marqs85/ossc_pcb/doc/bom_full.xls

Type | Id | Designator | Package | Quantity | Designation | MPN | Alternative part | Supplier URL
ICs
 | 1 | U8 | TSSOP-30_4.4x7.8mm_Pitch0.5mm_Handsoldering | 1 | PCM1862 | PCM1862DBTR |  | http://www.mouser.fi/ProductDetail/Texas-Instruments/PCM1862DBTR/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
 | 2 | U3 | TQFP-100_custom | 1 | IT6613 | IT6613E |  | Found on Aliexpress etc.
 | 3 | U10 | SOIC-8_3.9x4.9mm_Pitch1.27mm_Handsoldering | 1 | S25FL216K | IS25LP016D-JBLE |  | https://www.mouser.fi/ProductDetail/870-IS25LP016DJBLETR
 | 4 | U2 | TQFP-144_thermal | 1 | EP4CE15E22 | EP4CE15E22C8N |  | https://www.mouser.fi/ProductDetail/Intel-Altera/EP4CE15E22C8N
 | 5 | U1 | TQFP-100_thermal | 1 | TVP7002PZP | TVP7002PZP |  | https://www.mouser.fi/ProductDetail/Texas-Instruments/TVP7002PZP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
 | 6 | U4 | SOT-23-6_Handsoldering | 1 | SN74LVC2G17 | SN74LVC2G17DBVR |  | https://www.mouser.fi/Search/ProductDetail.aspx
 | 7 | U17 | TSSOP-20_4.4x6.5mm_Pitch0.65mm_Handsoldering | 1 | THS7353 | THS7353PWR |  | https://www.mouser.fi/Search/ProductDetail.aspx
Regulators
 | 8 | U7 | SOT-23-5_Handsoldering | 1 | NCP703SN19T1G | NCP703SN19T1G |  | http://www.mouser.fi/ProductDetail/ON-Semiconductor/NCP703SN19T1G/
 | 9 | U9 | SOT-23-5_Handsoldering | 1 | TLV70019 | TLV70019DDCT |  | https://www.mouser.fi/Search/ProductDetail.aspx
 | 10 | U15,U16 | SOT-23-5_Handsoldering | 2 | TLV70018 | TLV70018DDCT |  | https://www.mouser.fi/Search/ProductDetail.aspx
 | 11 | U6 | SOT-23-5_Handsoldering | 1 | TLV70033 | TLV70033DDCR |  | https://www.mouser.fi/Search/ProductDetail.aspx
 | 12 | U12,U14 | SOT-23-5_Handsoldering | 2 | TLV70012 | TLV70012DDCT |  | https://www.mouser.fi/Search/ProductDetail.aspx
 | 13 | U13 | SOT-23-5_Handsoldering | 1 | TLV70025 | TLV70025DDCT |  | https://www.mouser.fi/Search/ProductDetail.aspx
 | 14 | U5 | SOT-223_Handsoldering | 1 | AP7361C | AP7361C-33E-13 |  | http://www.mouser.fi/ProductDetail/Diodes-Incorporated/AP7361C-33E-13/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
 | 15 | U18 | SOT-23-5_Handsoldering | 1 | LM3671MF-2.5/NOPB | LM3671MF-2.5/NOPB |  | https://www.mouser.fi/ProductDetail/Texas-Instruments/LM3671MF-25-NOPB/?qs=QbsRYf82W3EGm7MxEdl1Ew%3D%3D
Connectors
 | 16 | P1 | VASCH5x2 | 1 | JTAG_CONN | 30310-6002HB |  | https://www.mouser.fi/Search/ProductDetail.aspx
 | 17 | P3 | DM3D-SF | 1 | mSD_CONN | DM3D-SF |  | https://www.mouser.fi/Search/ProductDetail.aspx?R=DM3D-SFvirtualkey64550000virtualkey798-DM3D-SF
 | 18 | J1 | VGA_CONN | 1 | VGA | ICD15S13E4GX00LF |  | https://www.mouser.fi/Search/ProductDetail.aspx
 | 19 | J3 | SCART_CONN | 1 | SCART-F | K-SCARTX-022 | CS-107 | Found on Aliexpress etc.
 | 20 | J2 | 3xRCA_CONN | 1 | 3XRCA_CONN | PJRAN3X1U03X |  | http://www.mouser.fi/ProductDetail/Switchcraft/PJRAN3X1U03X/
 | 21 | J5 | BARREL_JACK_roundconn | 1 | 5VDC_IN | 163-179PH-EX |  | https://www.mouser.fi/Search/ProductDetail.aspx
 | 22 | J6,J7 | SJ1-3533NG | 2 | SJ1-3533NG | SJ1-3533NG |  | http://www.mouser.fi/ProductDetail/CUI-Inc/SJ1-3533NG/
 | 23 | J4 | HDMI_CONN-10029449-111RLF | 1 | HDMI_CONN | 10029449-111RLF |  | http://www.mouser.fi/Search/ProductDetail.aspx
Switches / buttons
 | 24 | SW3,SW2 | SW_PUSH-SKHCBFA010 | 2 | SW_PUSH | SKHCBFA010 |  | https://www.mouser.fi/Search/ProductDetail.aspx
 | 25 | SW1 | SW_SPDT | 1 | SPST | 100SP1T1B1M2QEH |  | http://www.mouser.fi/Search/ProductDetail.aspx
 | 26 | SW4 | GW22RxV | 1 | GW22RCV | GW22RBV |  | https://www.mouser.fi/ProductDetail/NKK-Switches/GW22RBV/
SMD R/L/C/D/Q
 | 27 | D1 | LED-0603 | 1 | LEDR | LTST-C194KRKT |  | https://www.mouser.fi/Search/ProductDetail.aspx
 | 28 | D2 | LED-0603 | 1 | LEDG | LTST-C194KGKT |  | https://www.mouser.fi/Search/ProductDetail.aspx
 | 29 | D4,D3 | SOT-665 | 2 | PESD3V3V4UW | PESD3V3V4UW |  | https://www.mouser.fi/ProductDetail/Nexperia/PESD3V3V4UW115/?qs=LOCUfHb8d9t0XGTkzdBMLg%3D%3D
 | 30 | D12,D11,D5 | SOT-23_Handsoldering | 3 | PESD12VL2BT | PESD12VL2BT |  | https://www.mouser.fi/ProductDetail/Nexperia/PESD12VL2BT215/?qs=LOCUfHb8d9uAuKXx9HIYFw%3D%3D
 | 31 | D10,D9,D8 | SOT-665 | 3 | PESD5V0U4BW | PESD5V0U4BW |  | https://www.mouser.fi/ProductDetail/Nexperia/PESD5V0U4BW115/?qs=PJ263BbL1t0YkETjSt5Low%3D%3D
 | 32 | D15,D13 | SOT-665 | 2 | PESD5V0V4UW | PESD5V0V4UW |  | https://www.mouser.fi/ProductDetail/Nexperia/PESD5V0V4UW115/?qs=LOCUfHb8d9ugScE2ypB%2FRQ%3D%3D
 | 33 | D7,D6 | SLP2510P8 | 2 | RClamp0524P | RCLAMP0524PATCT |  | http://www.mouser.fi/ProductDetail/Semtech/RCLAMP0524PATCT/
 | 34 | D14 | SOT-23_Handsoldering | 1 | BZX84C5V1/SOT | BZX84-C5V1 |  | https://www.mouser.fi/ProductDetail/Nexperia/BZX84-C5V1215/?qs=me8TqzrmIYVKCqOFbOtofg%3D%3D
 | 35 | L1 | CDRH2D14 | 1 | 2.2u | CDRH2D14NP-2R2NC |  | https://www.mouser.fi/ProductDetail/Sumida/CDRH2D14NP-2R2NC/?qs=yEEOfDmvQDXT35Jdz6aZxg%3D%3D
 | 36 | Q1 | SOT-23_Handsoldering | 1 | BC847 | BC847C,215 |  | https://www.mouser.fi/Search/ProductDetail.aspx
 | 37 | Q2 | SOT-23_Handsoldering | 1 | BC857 | BC857C,215 |  | https://www.mouser.fi/Search/ProductDetail.aspx
 | 38 | Q5,Q3 | SOT-23_Handsoldering | 2 | AOSS21115C | AOSS21115C |  | https://www.digikey.fi/product-detail/en/alpha-omega-semiconductor-inc/AOSS21115C/785-AOSS21115CCT-ND/12327570
 | 39 | Q4 | SOT-23_Handsoldering | 1 | DSS20200L | DSS20200L |  | https://www.mouser.fi/ProductDetail/Diodes-Incorporated/DSS20200L-7/?qs=oUsD4qhOtFyoU8lfgTjONg%3D%3D
 | 40 | FB6,FB1,FB2,FB4,FB5,FB7 | SM0603_Resistor_libcms | 6 | MPZ1608S221A | MPZ1608S221A |  | https://www.mouser.fi/Search/ProductDetail.aspx
 | 41 | R23 | SM0603_Resistor_libcms | 1 | 25 | RR0816Q-24R9-D-39R | RC0603FR-0724R9L | https://www.mouser.fi/Search/ProductDetail.aspx
 | 42 | R34,R27 | SM0603_Resistor_libcms | 2 | 47 | RR0816Q-470-D | RC0603FR-0747RL | https://www.mouser.fi/ProductDetail/Susumu/RR0816Q-470-D/
 | 43 | R1,R2,R4,R5,R6,R7,R8,R9,R10,R3 | SM0603_Resistor_libcms | 10 | 75 | RG1608P-750-D-T5 | RT0603DRE0775RL | https://www.mouser.fi/Search/ProductDetail.aspx
 | 44 | R64,R63,R62,R61,R60,R59,R38,R44 | SM0603_Resistor_libcms | 8 | 100 | RR0816P-101-D | RC0603FR-07100RL | https://www.mouser.fi/ProductDetail/Susumu/RR0816P-101-D/
 | 45 | R12 | SM0603_Resistor_libcms | 1 | 220 | RR0816P-221-D | RC0603FR-07220RL | http://www.mouser.fi/ProductDetail/Susumu/RR0816P-221-D/
 | 46 | R35,R36 | SM0603_Resistor_libcms | 2 | 330 | RR0816P-331-D | RC0603FR-07330RL | https://www.mouser.fi/Search/ProductDetail.aspx
 | 47 | R55 | SM0805_libcms | 1 | 330 | CRCW0805330RFKEAHP |  | https://www.mouser.fi/ProductDetail/Vishay-Dale/CRCW0805330RFKEAHP/
 | 48 | R25 | SM0603_Resistor_libcms | 1 | 698 | RR0816P-6980-D-82A | RT0603DRE07698RL | https://www.mouser.fi/Search/ProductDetail.aspx
 | 49 | R20,R26,R37,R40 | SM0603_Resistor_libcms | 4 | 1k | RR0816P-102-D | RC0603FR-071KL | https://www.mouser.fi/Search/ProductDetail.aspx
 | 50 | R11 | SM0603_Resistor_libcms | 1 | 1.5k | RR0816P-152-D | RC0603FR-071K5L | https://www.mouser.fi/ProductDetail/Susumu/RR0816P-152-D/
 | 51 | R13,R14,R15 | SM0603_Resistor_libcms | 3 | 2.2k | RR0816P-222-D | RC0603FR-072K2L | https://www.mouser.fi/ProductDetail/Susumu/RR0816P-222-D/
 | 52 | R19,R24,R41,R45,R46 | SM0603_Resistor_libcms | 5 | 4.7k | RR0816P-472-D | RC0603FR-074K7L | https://www.mouser.fi/ProductDetail/Susumu/RR0816P-472-D/
 | 53 | R58,R56 | SM0603_Resistor_libcms | 2 | 6.8k | RR0816P-682-D | RC0603FR-076K8L | https://www.mouser.fi/ProductDetail/Susumu/RR0816P-682-D/
 | 54 | R16,R17,R18,R21,R22,R28,R29,R30,R31,R32,R33,R42,R43,R39 | SM0603_Resistor_libcms | 14 | 10k | RR0816P-103-D | RC0603FR-0710KL | https://www.mouser.fi/Search/ProductDetail.aspx
 | 55 | R54,R53 | SM0603_Resistor_libcms | 2 | 27k | RR0816P-273-D | RC0603FR-0727KL | https://www.mouser.fi/ProductDetail/Susumu/RR0816P-273-D/
 | 56 | R57,R47,R48,R49,R50,R51,R52 | SM0603_Resistor_libcms | 6 | 100k | RR0816P-104-D | RC0603FR-07100KL | http://www.mouser.fi/ProductDetail/Susumu/RR0816P-104-D/
 | 57 | C33,C36 | SM0603_Capa_libcms | 2 | 22p | GRM1885C1H220JA01D | CC0603JRNPO9BN220 | http://www.mouser.fi/ProductDetail/Murata-Electronics/GRM1885C1H220JA01D/
 | 58 | C111,C112 | SM0603_Capa_libcms | 2 | 30p | GRM1885C1H300FA01D | CC0603JRNPO9BN300 | http://www.mouser.fi/ProductDetail/Murata-Electronics/GRM1885C1H300FA01D/
 | 59 | C11,C13,C16,C24 | SM0603_Capa_libcms | 4 | 1n | VJ0603Y102KXACW1BC | CC0603KRX7R9BB102 | https://www.mouser.fi/Search/ProductDetail.aspx
 | 60 | C19 | SM0603_Capa_libcms | 1 | 4.7n | VJ0603Y472KXBPW1BC | C1608X7R1H472KT000N | https://www.mouser.fi/Search/ProductDetail.aspx
 | 61 | C132,C131,C130,C129,C128,C127,C17,C25,C70,C104,C105,C106 | SM0603_Capa_libcms | 12 | 10n | VJ0603Y103KXACW1BC | CC0603KRX7R9BB103 | https://www.mouser.fi/Search/ProductDetail.aspx
 | 62 | C1,C2,C8,C9,C10,C14,C15,C18,C20,C21,C22,C23,C26,C27,C28,C39,C40,C41,C42,C43,C44,C45,C46,C47,C48,C50,C51,C53,C54,C55,C57,C58,C59,C60,C61,C62,C63,C64,C65,C66,C67,C68,C69,C73,C74,C75,C77,C78,C79,C80,C81,C82,C83,C84,C85,C86,C99,C101,C72,C76,C100,C103,C114,C118 | SM0603_Capa_libcms | 64 | 0.1u | VJ0603Y104JXJPW1BC | CC0603KRX7R9BB104 | https://www.mouser.fi/Search/ProductDetail.aspx
 | 63 | C3,C4,C5,C6,C7,C12,C29,C30,C32,C34,C35,C37,C38,C52,C56,C87,C88,C89,C90,C91,C92,C94,C95,C96,C97,C98 | SM0603_Capa_libcms | 26 | 1u | GRT188R61H105KE13D | CC0603KRX7R8BB105 | https://www.mouser.fi/ProductDetail/Murata-Electronics/GRT188R61H105KE13D
 | 64 | C119,C120 | SM0603_Capa_libcms | 2 | 2.2u | GCM188R70J225KE22D | GRM188Z71E225KE43D | http://www.mouser.fi/ProductDetail/Murata-Electronics/GCM188R70J225KE22D/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
 | 65 | C116,C121,C122,C117,C31,C93,C49,C108,C109,C110,C113,C115,C123,C124,C125,C126 | SM0603_Capa_libcms | 16 | 10u | ZRB18AR61E106ME01L | GRM188Z71A106KA73D | https://www.mouser.fi/ProductDetail/Murata-Electronics/ZRB18AR61E106ME01L
 | 66 | C102,C71,C107 | SM0805_libcms | 3 | 47u | GRM21BR60J476ME15L | CL21A476MQYNNNG | http://www.mouser.fi/Search/ProductDetail.aspx
Misc
 | 67 | F1 | SM0603_Resistor_libcms | 1 | F0603E1R25FSTR | F0603E1R25FSTR |  | https://www.mouser.fi/ProductDetail/AVX/F0603E1R25FSTR/
 | 68 | F2 | SM0603_Resistor_libcms | 1 | MF-FSMF020X-2 | MF-FSMF020X-2 |  | https://www.mouser.fi/Search/ProductDetail.aspx
 | 69 | Y1 | ACHL-OSC | 1 | ACHL-27MHZ-EK | ACHL-27.000MHZ-EK |  | https://www.mouser.fi/Search/ProductDetail.aspx
 | 70 | Y2 | ECS-3X9X | 1 | 24.576MHz | ECS-245.7-18-9X |  | http://www.mouser.fi/Search/ProductDetail.aspx
 | 71 | U11 | IRM-V5XX_TR1 | 1 | IRM-V538/TR1 | IRM-V538/TR1 |  | Found on Aliexpress etc.
 | 72 | DS1 | NHD-C0216CZ_vertmount | 1 | CONN_01X12 | NHD-C0216CZ-FSW-FBW-3V3 |  | https://www.mouser.fi/Search/ProductDetail.aspx
Case mechanical
 | 73 | 12mm nylon spacer between PCB and mid plexi |  | 4 |  | R30-1611200 |  | https://www.mouser.fi/Search/ProductDetail.aspx
 | 74 | 8mm nylon spacer between top and mid plexi |  | 4 |  | R30-1610800 |  | https://www.mouser.fi/Search/ProductDetail.aspx
 | 75 | M3 nut between bottom plexi and PCB |  | 4
 | 76 | M3 x 16mm screw, DIN-7985 |  | 4
 | 77 | M3 x 10mm screw, DIN-7985 |  | 4
 | 78 | Bumper pad |  | 4 |  | SJ-5312 CLEAR |  | http://www.mouser.fi/ProductDetail/3M-Electronic-Specialty/SJ-5312-CLEAR/
 | 79 | 14mm x 14mm heatsink with adhesive tape for TVP7002 |  | 1 |  | GD024 |  | http://www.aliexpress.com/item/50pcs-lot-Aluminum-Cooling-Heat-sink-14-x-14-x-6MM-Golden-Chipset-RAM-Heatsink-Radiator/32245171440.html
 |  |  |  |  |  | (=included in VGP advanced DIY kit)
