marqs85/ossc_pcb/case/ossc_case_bottom.step

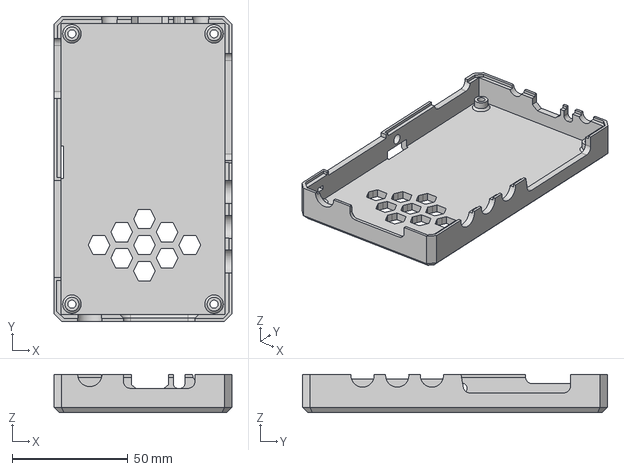
[picture p1: CAD file, 2021-12-11]
case/ossc_case_bottom.step
77.0 x 132.0 x 16.5 mm
