marqs85/ossc_pcb/case/ossc_case_top.step

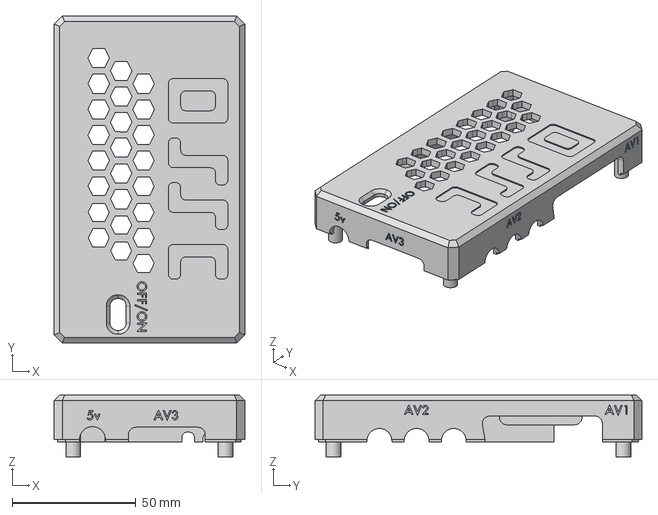
[picture p2: CAD file, 2021-12-11]
case/ossc_case_top.step
77.0 x 132.0 x 25.0 mm
