marqs85/ossc_pcb/(threads)

Thread 1 (2017-04-05):

Can we have the pcb files for V1.5 of the board?

renegadeandy, 2017-04-05:
Hi Marqs!

Can you please upload the v1.5 ossc perhaps into a v1.5 branch? I am considering ordering a couple of the boards myself and this would help me out a lot!

Also - is there a way I can contact you directly?

Many thanks

marqs85, 2017-04-23:
v1.5 and earlier pcb files are not that well maintained and contain legacy stuff that may work well with recent Kicad versions so aside from gerbers they might not be that useful. Just uploaded finished v1.6 design (untested yet though) that should be used for new boards.

My contact details can be found on top of ossc source files (Verilog/C) in the main repo.

Closed 2017-06-06.

Thread 2 (2017-06-05):

Acrylic case designs

dwhinham, 2017-06-05:
Hi marqs!

Would it be possible to please get the designs/files for the acrylic case as seen in the OSSCs sold by VideogamePerfection?

Maybe a separate repo would be more appropriate, if not here.

Thanks very much! :)

marqs85, 2017-06-06:
Case design for v1.6 PCB will be added here once it is finished

Closed 2017-06-06.

Thread 5 (2018-01-20):

Alternative for S25FL116K0XMFI041

stozze, 2018-01-20:
Hi,

First of all, thank you for making the OSSC open hardware/source, excellent work.

I've been busy soldering together an OSSC and today I finally got it completed and it worked like a charm, no magic smoke :). But I was not able to source the S25FL116K0XMFI041 (seems like these are no longer manufactured?) but I found a drop-in replacement that can be used instead, the IS25LP016D-JNLE, this one is more readily available and seems to work fine as a replacement, at least on the board I got up and running today, Quartus didn't complain about it either and programmed it just fine.

https://www.mouser.fi/ProductDetail/870-IS25LP016D-JNLE

So for the next version of the board maybe it would be better to use this one instead as it is more readily available?

marqs85, 2018-01-20:
Updated BOM with the part in 35ba794.

Closed 2018-01-20.

Thread 6 (2018-07-07):

OSSC_BOARD.WRL v1.5

Deneteus, 2018-07-07:
Howdy Marqs!

I need the OSSC_BOARD.WRL file from 1.5 or a 3D render of the 1.5 board with components. from the 1.5 Branch. Thanks in advance!

marqs85, 2018-07-09:
I can generate WRL of the PCB itself, but there are no 3d models for manually created components. Basic components also may not map automatically to 3d models due to v1.5 having been done with old Kicad version which has different library format than Kicad 5.0.

Deneteus, 2018-07-24:
That would work.

marqs85, 2018-07-30:
WRL for v1.5-DIY is now uploaded [here](https://www.niksula.hut.fi/~mhiienka/ossc/diy-v1.5/pcb1.5-diy.wrl).

Closed 2018-09-28.

Thread 8 (2019-10-24):

Y2 Unsecured

gbrown128, 2019-10-24:
Hi Marqs,
On my unit Y2 (audio ADC crystal) was installed with quite a lot of lead length between it and the board. It had flopped over and was worryingly close to touching the back of the SCART connector pins.

Depends on your manufacturing process, but I'd suggest swapping to a horizontal footprint with a solder pad to tie the crystal can to the PCB, or adding the wire loop to brace the crystal in place, or just some super glue, as I've used to fix mine!

 Otherwise very pleased with the design - thank you very much!

marqs85, 2019-10-25:
Where did you buy your board from? The crystal should lie horizontally without too much extra lead length. A different footprint could indeed be a better solution even though so far I've not heard anyone else having such issues. SMD footprint would most compact and robust, but it's not ideal when DIY aspect is considered.

gbrown128, 2019-10-28:
Board came from videogameperfection.com  Unfortunately I neglected to grab a picture before gluing it down, but that's the amount of lead length present on my unit.

It's possible my unit just had a rather rough ride in shipping, but the crystal was bent over about 45 degrees in all three axes. To be fair it is quite possible it would've never caused an issue. I just happened to take the lid off my unit out of curiosity and the crystal caught my eye! Given this unit will travel a lot I thought it best to glue it down!

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

marqs85, 2019-10-29:
The problem has been reported to manufacturer, closing the issue.

Closed 2019-10-29.
