marqs85/ossc_pcb/doc/ossc_board.pdf

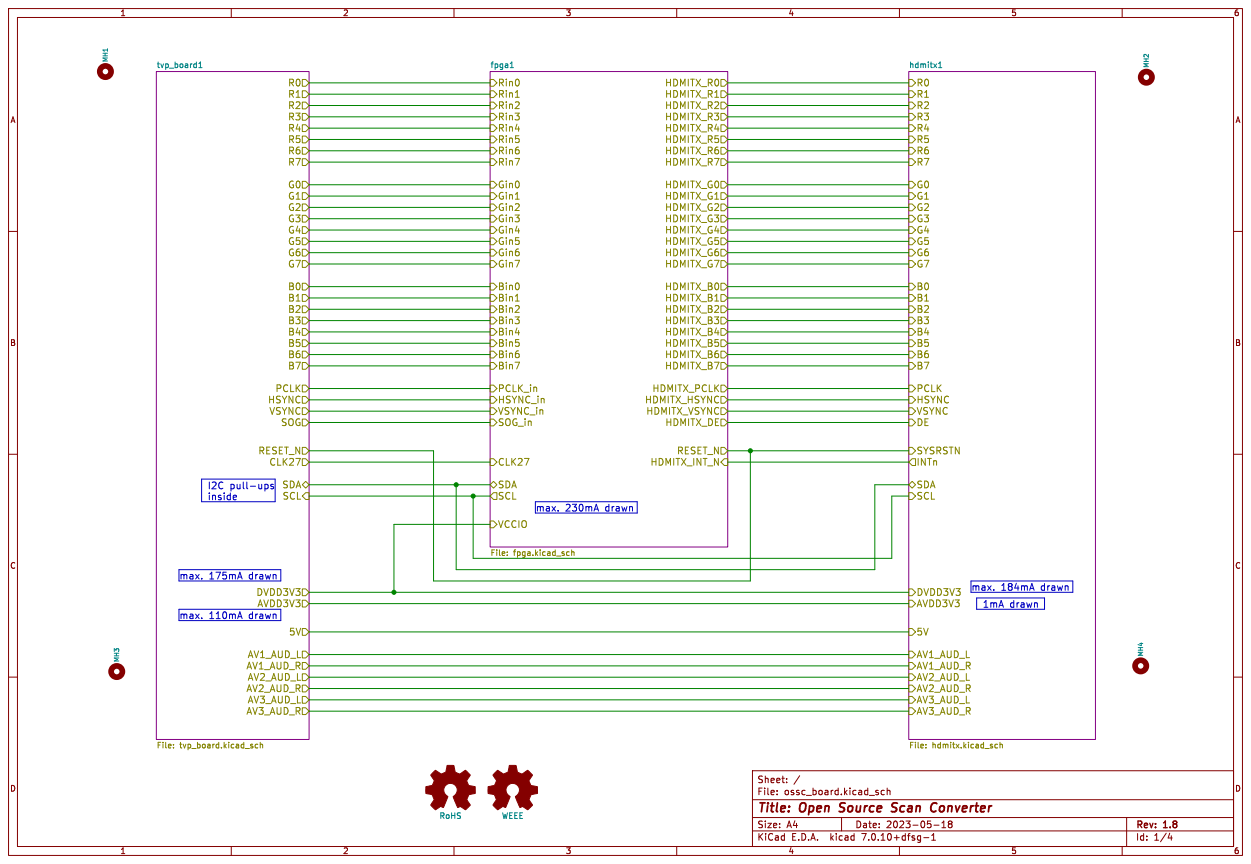
[picture p3: page 1]

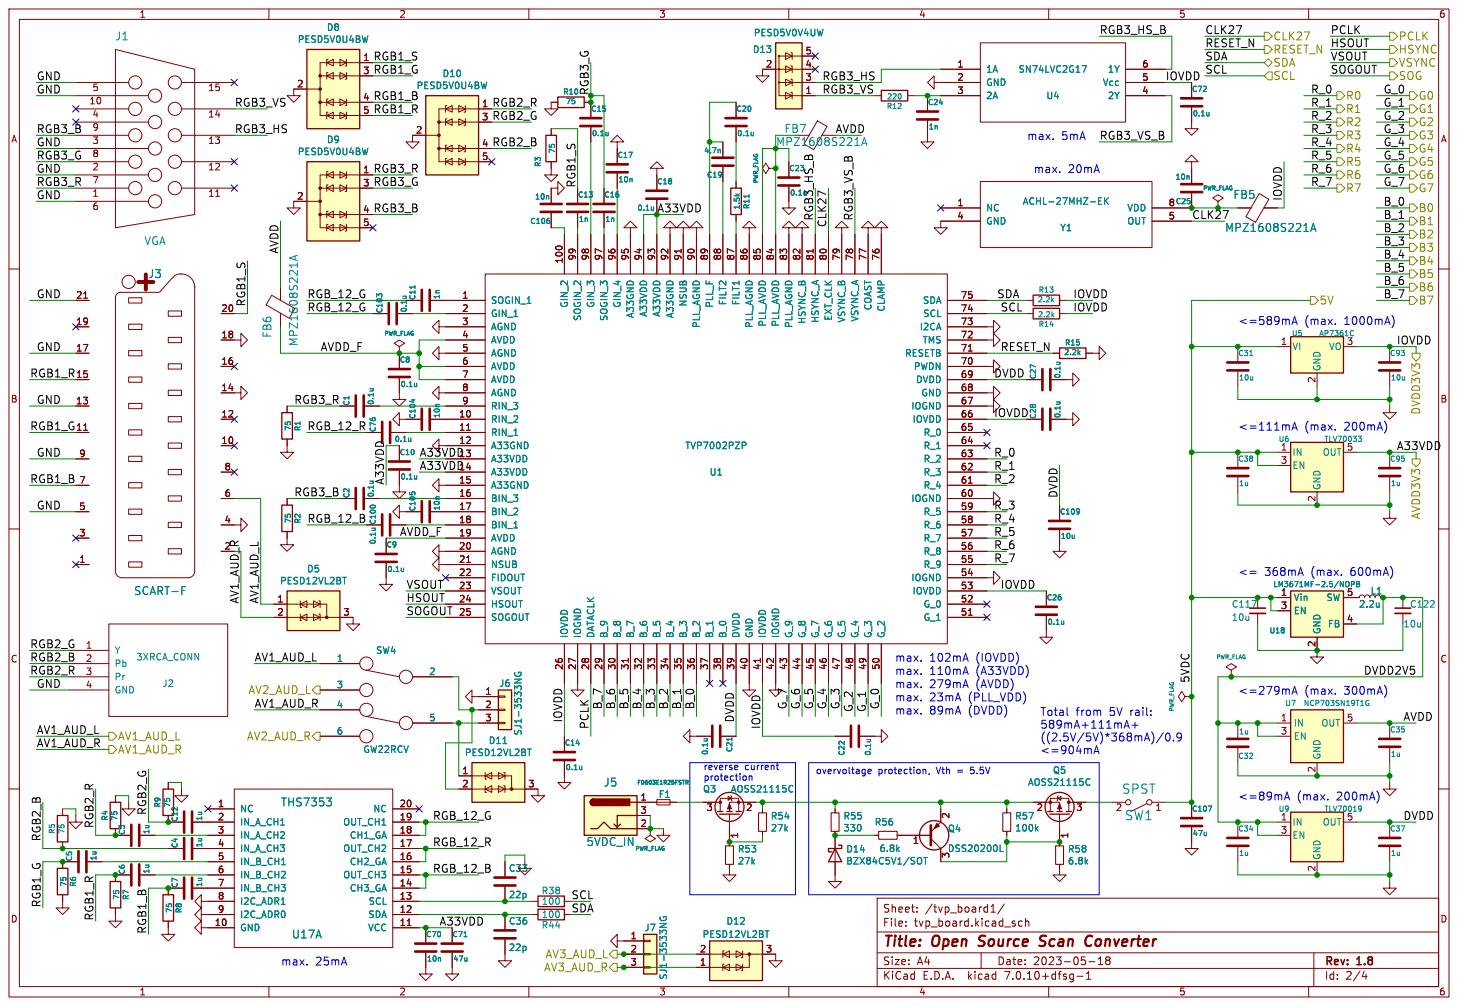
[picture p4: page 2]

Id: 2/4 Title: Open Source Scan Converter File: tvp_board.kicad_sch Sheet: /tvp_board1/ C36

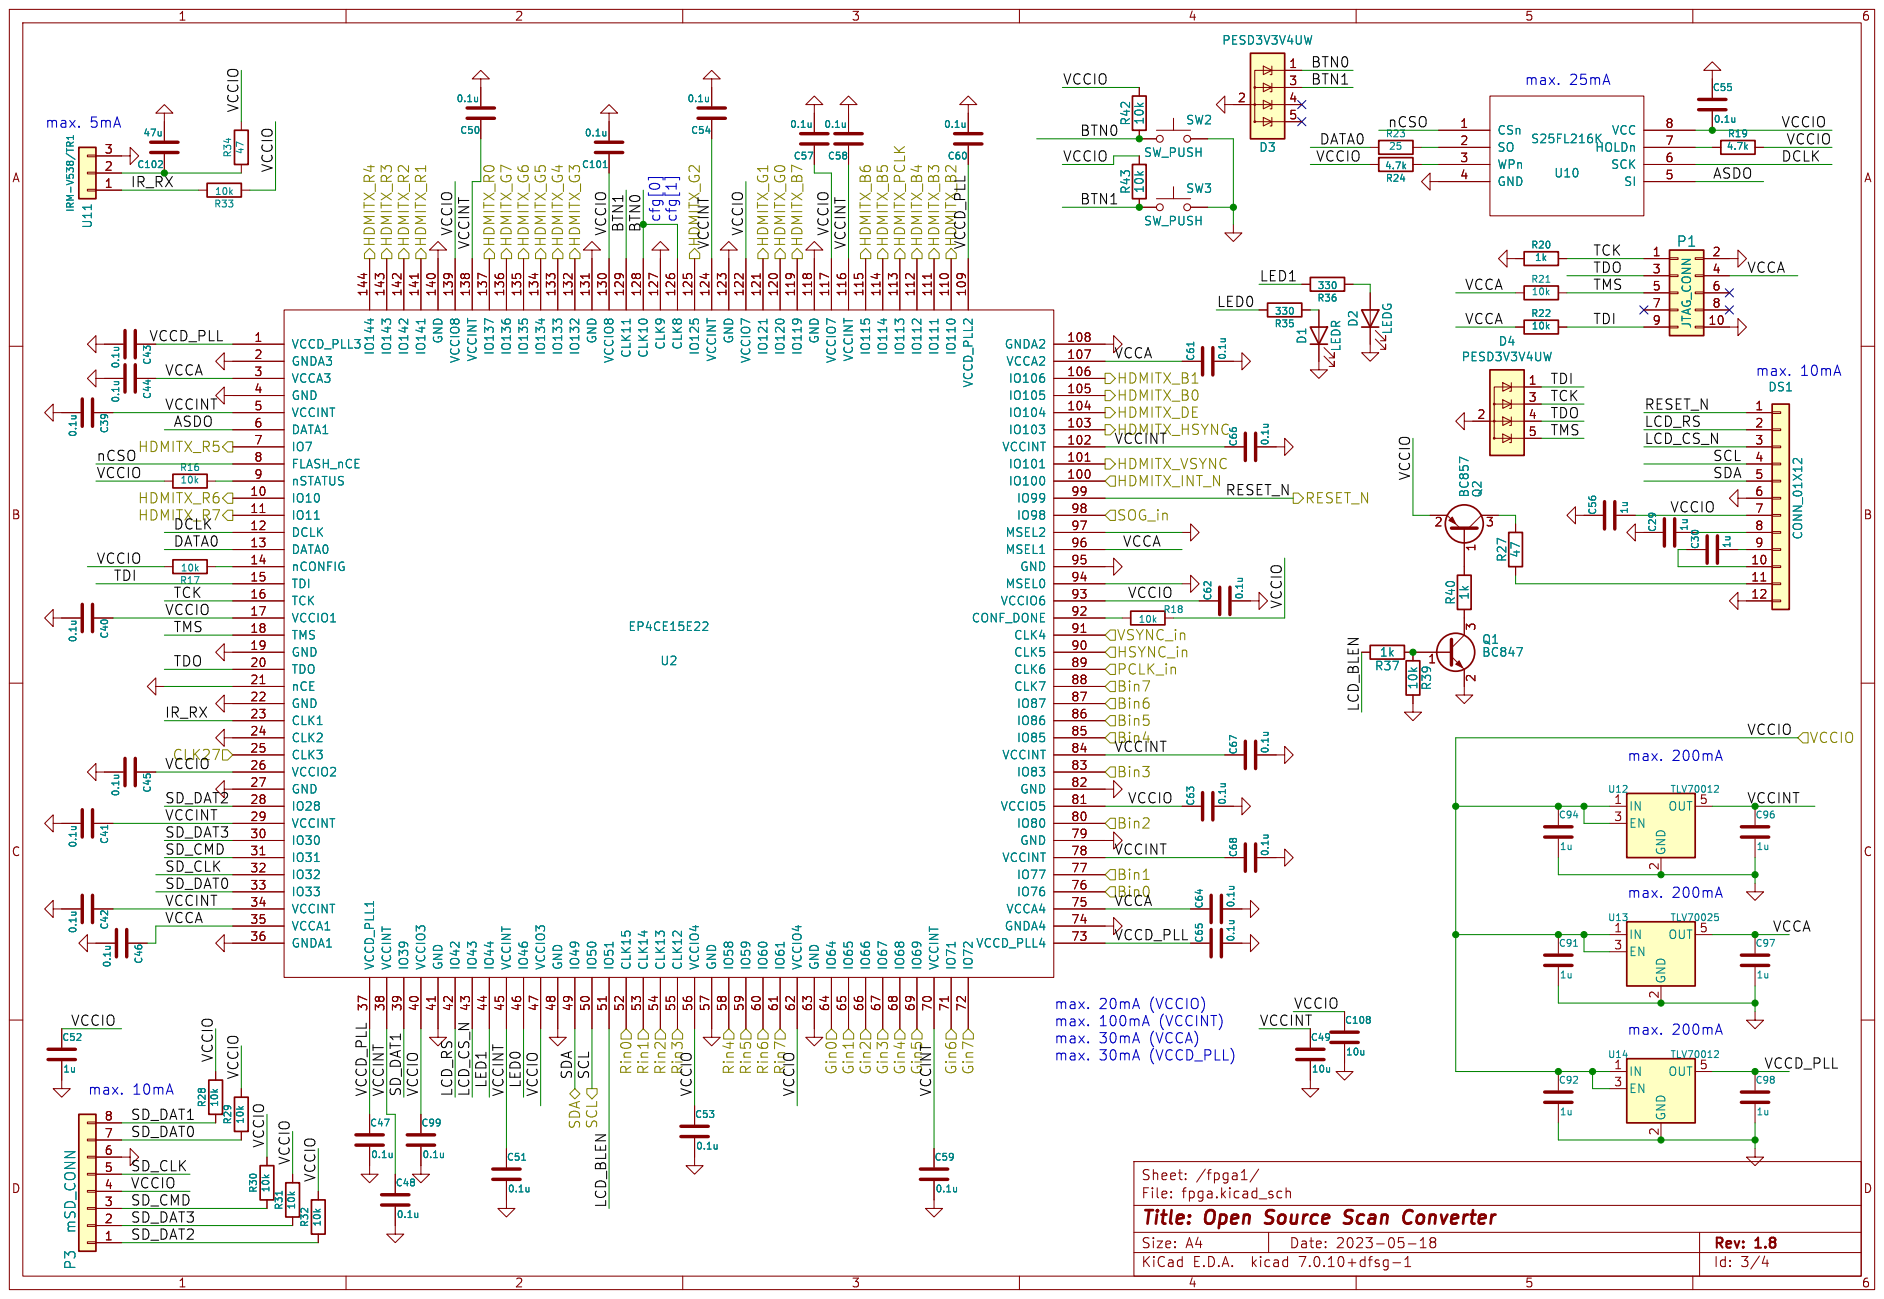
[picture p5: page 3]

Id: 3/4 Title: Open Source Scan Converter File: fpga.kicad_sch Sheet: /fpga1/

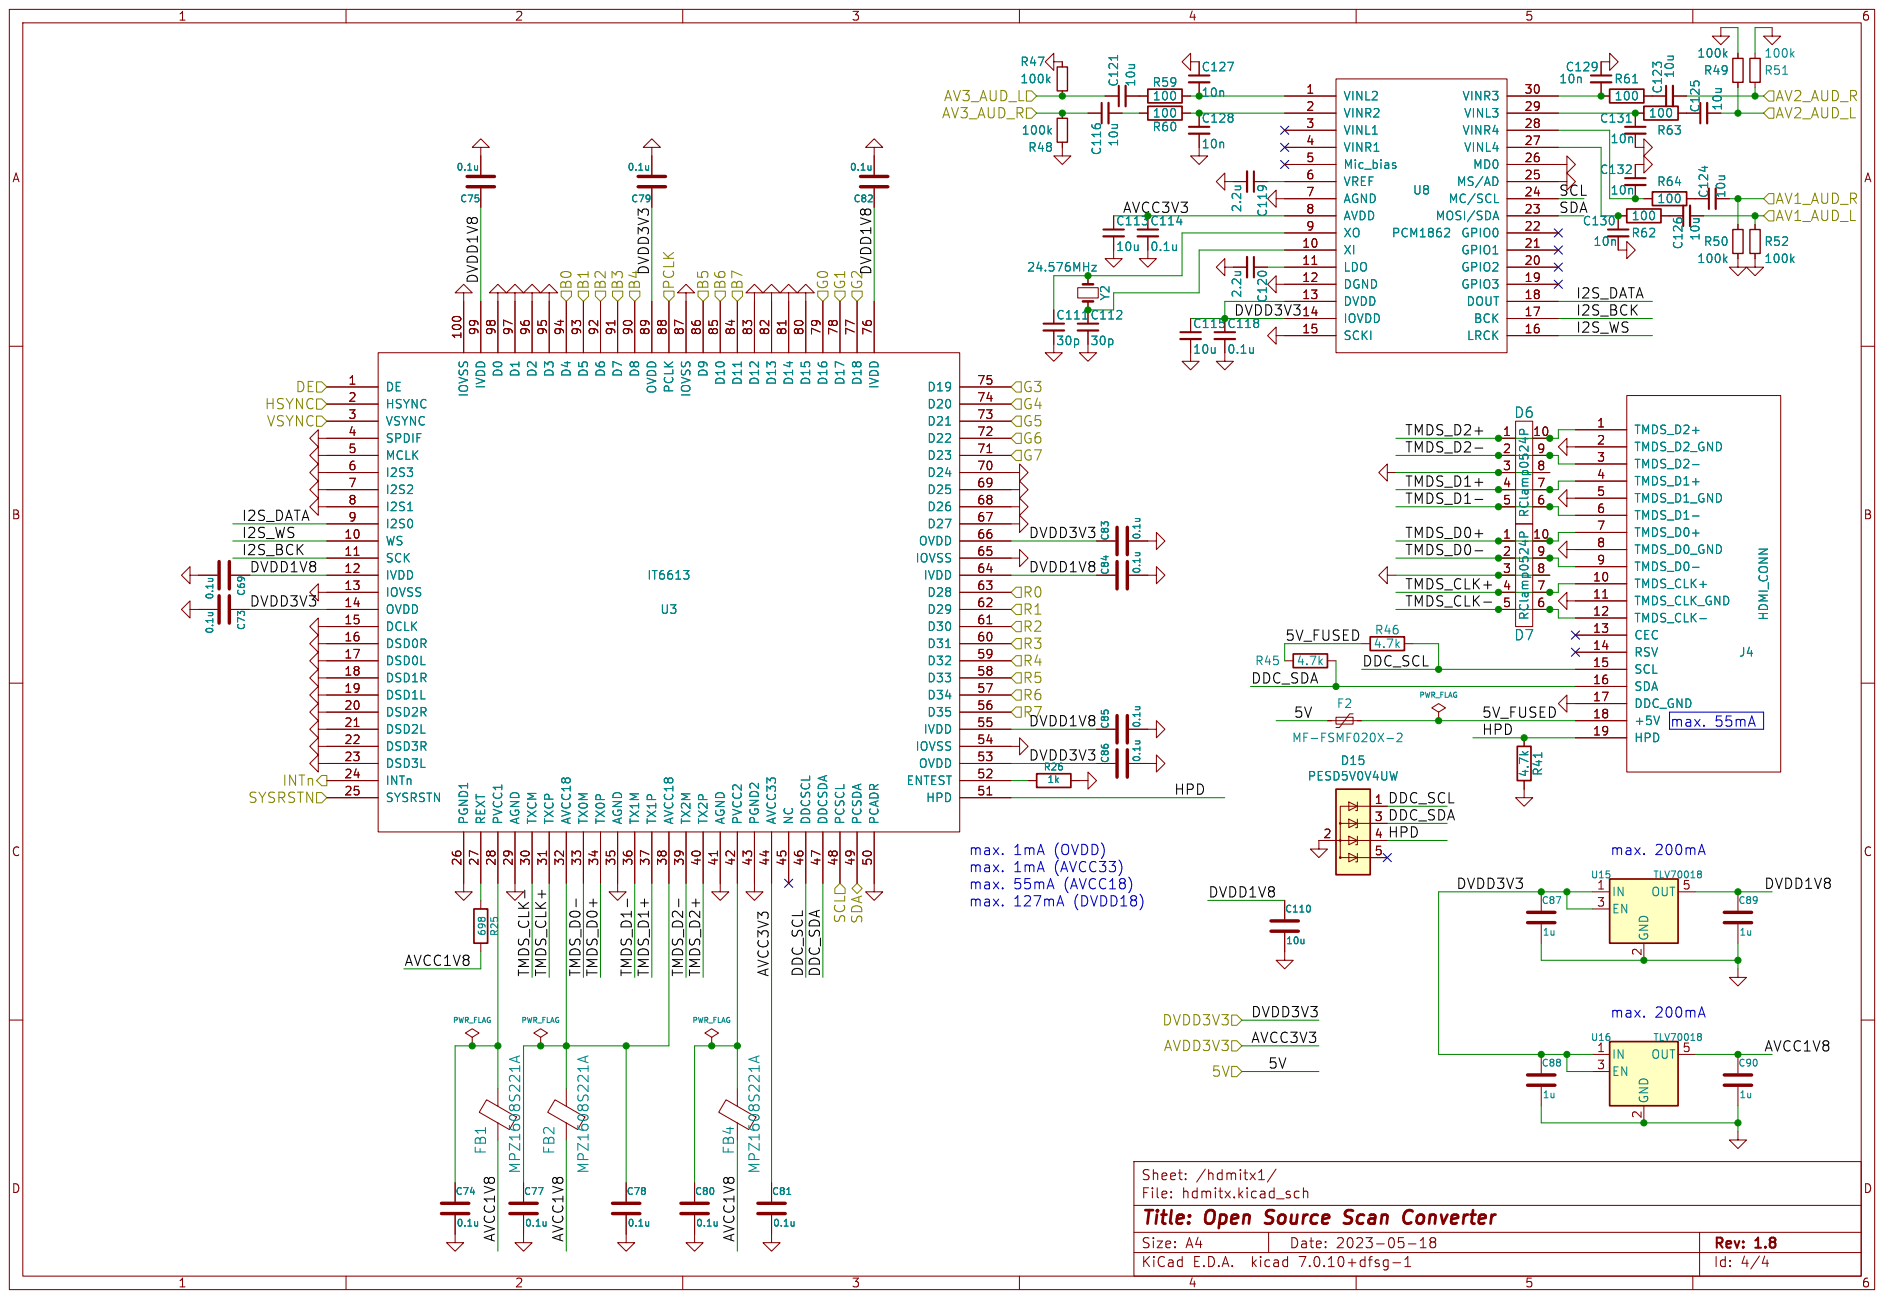
[picture p6: page 4]
