marqs85/ossc_pcb/ossc_board.kicad_pcb

## KiCad design ossc_board.kicad_pcb (2021-07-22)

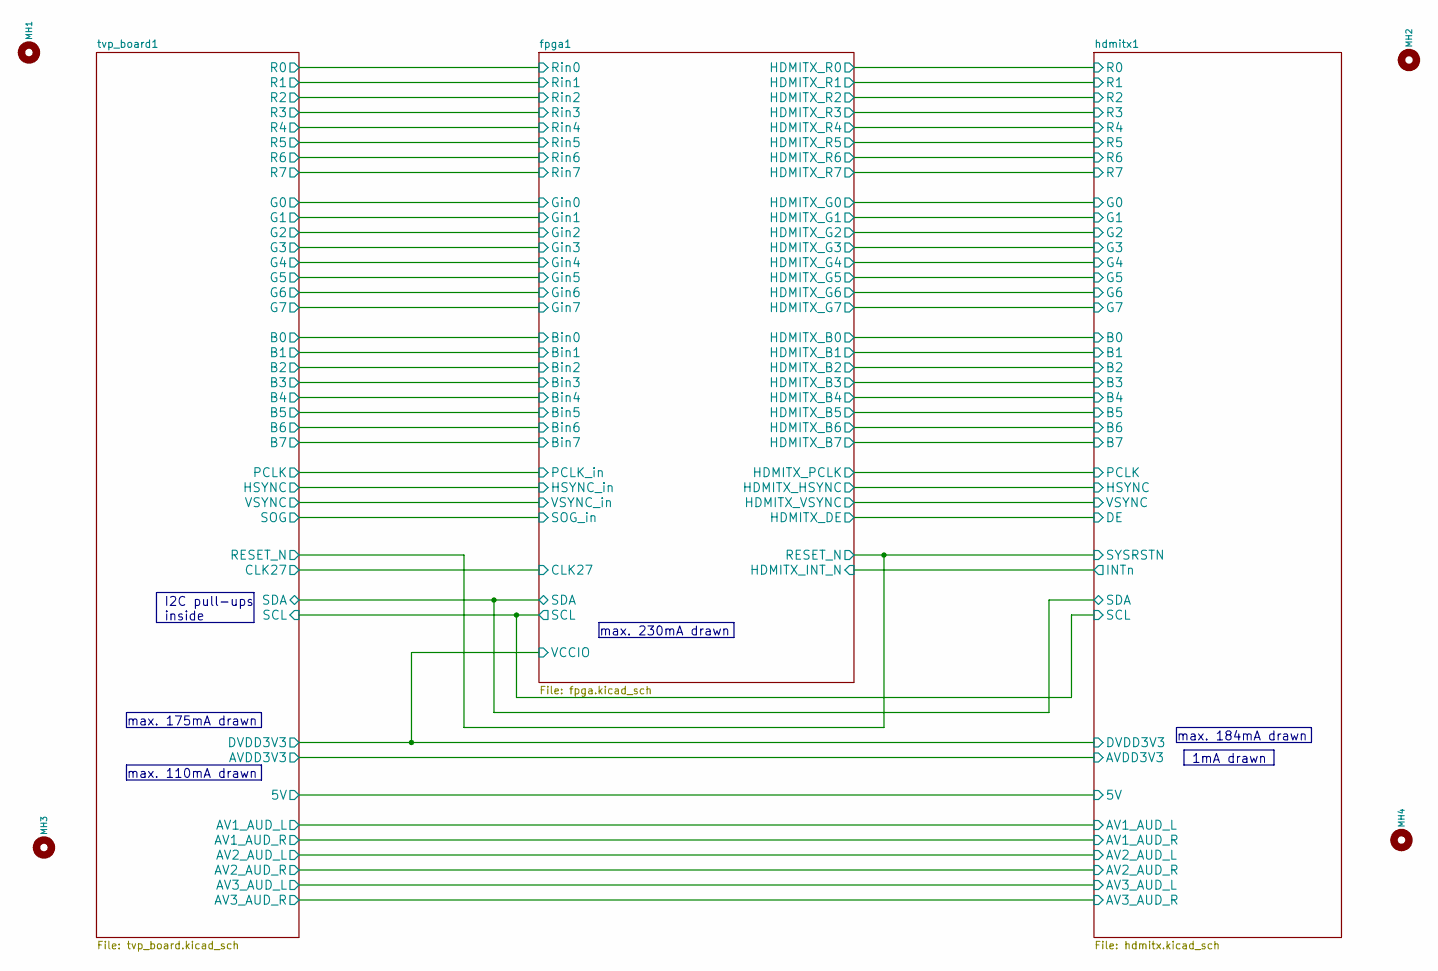
[picture p7: schematic ossc_board.kicad_sch, Open Source Scan Converter]

Parts:
MH1, MH2, MH3, MH4: CONN_1; 1pin

Notes on the sheet:
1mA drawn
max. 230mA drawn
max. 184mA drawn
max. 110mA drawn
max. 175mA drawn
I2C pull-ups inside

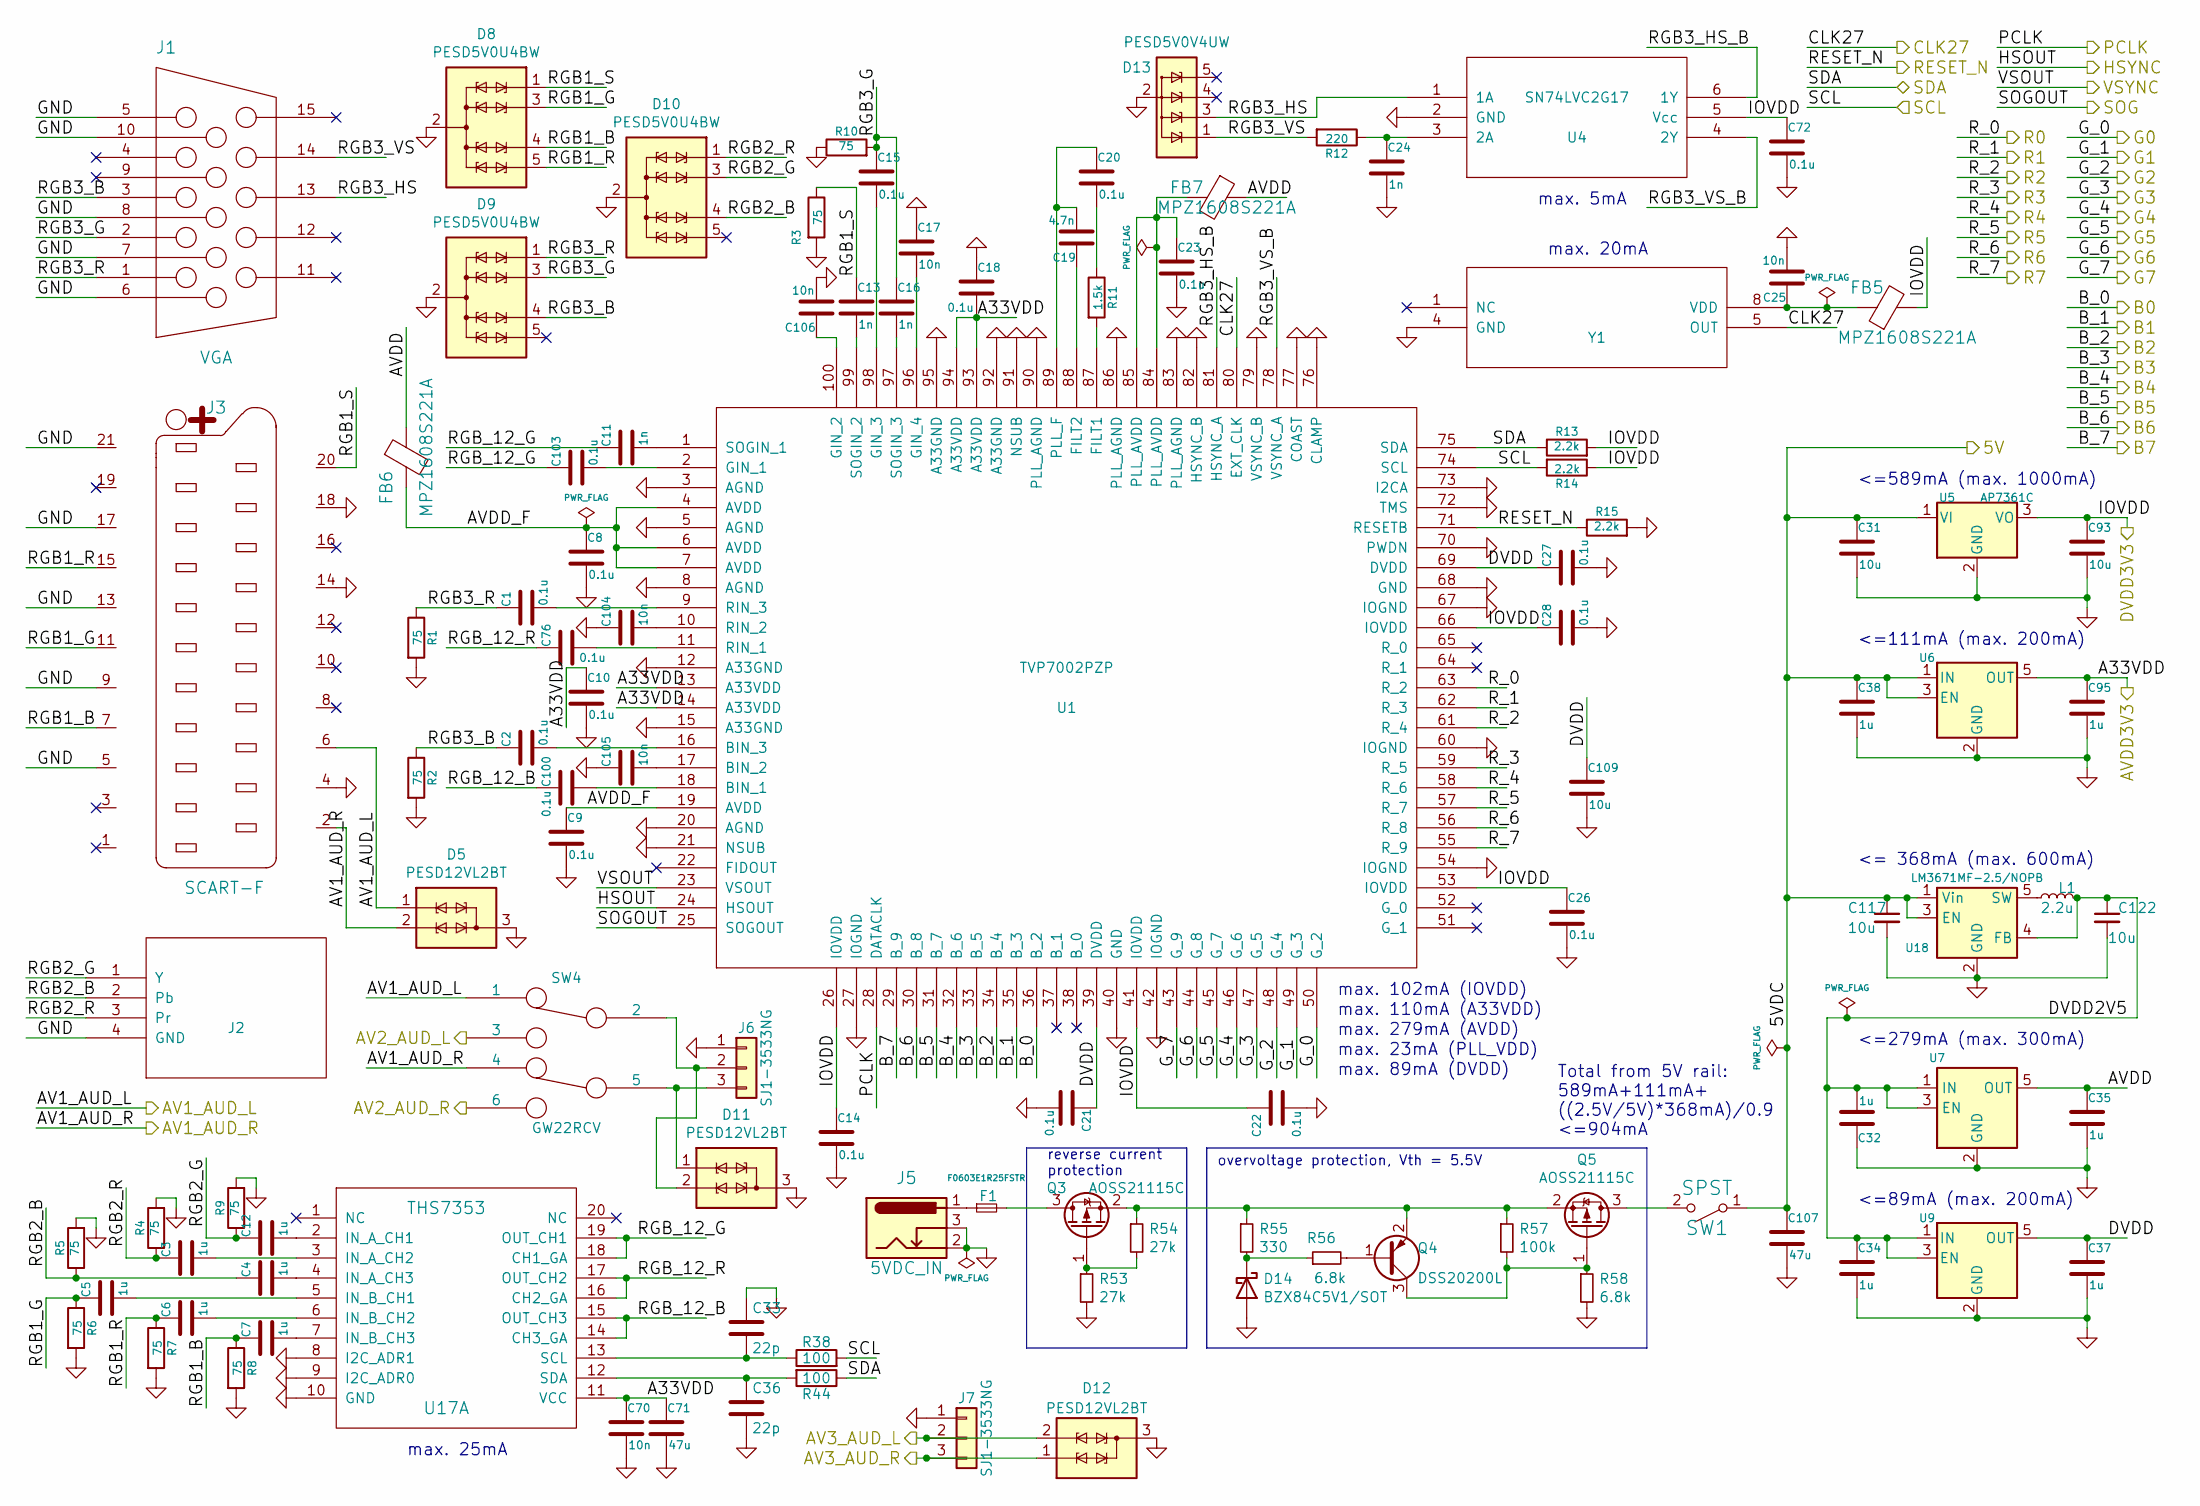
[picture p8: schematic tvp_board.kicad_sch, Open Source Scan Converter]

Parts:
C1, C2, C8, C9, C10, C14, C15, C18, C20, C21, C22, C23, C26, C27, C28, C72, C76, C100, C103: 0.1u; SM0603_Capa_libcms
C3, C4, C5, C6, C7, C12, C32, C34, C35, C37, C38, C95: 1u; SM0603_Capa_libcms
C11, C13, C16, C24: 1n; SM0603_Capa_libcms
C17, C25, C70, C104, C105, C106: 10n; SM0603_Capa_libcms
C19: 4.7n; SM0603_Capa_libcms
C31, C93, C109, C117, C122: 10u; SM0603_Capa_libcms
C33, C36: 22p; SM0603_Capa_libcms
C71, C107: 47u; SM0805_libcms
D5, D11, D12: PESD12VL2BT; SOT-23_Handsoldering
D8, D9, D10: PESD5V0U4BW; SOT-665
D13: PESD5V0V4UW; SOT-665
D14: BZX84C5V1/SOT; D_SOT-23_ANK
F1: F0603E1R25FSTR; SM0603_Resistor_libcms
FB5, FB6, FB7: MPZ1608S221A; SM0603_Resistor_libcms
J1: VGA; VGA_CONN
J2: (no value)
J3: SCART-F; SCART_CONN
J5: 5VDC_IN; BARREL_JACK_roundconn
J6, J7: SJ1-3533NG
L1: 2.2u; CDRH2D14
Q3, Q5: AOSS21115C; SOT-23_Handsoldering
Q4: DSS20200L; SOT-23_Handsoldering
R1, R2, R3, R4, R5, R6, R7, R8, R9, R10: 75; SM0603_Resistor_libcms
R11: 1.5k; SM0603_Resistor_libcms
R12: 220; SM0603_Resistor_libcms
R13, R14, R15: 2.2k; SM0603_Resistor_libcms
R38, R44: 100; SM0603_Resistor_libcms
R53, R54: 27k; SM0603_Resistor_libcms
R55: 330; SM0805_libcms
R56, R58: 6.8k; SM0603_Resistor_libcms
R57: 100k; SM0603_Resistor_libcms
SW1: SPST; SW_SPDT
SW4: GW22RCV; GW22RxV
U1: TVP7002PZP; TQFP-100_thermal
U4: SN74LVC2G17; SOT-23-6_Handsoldering
U5: AP7361C; SOT-223_Handsoldering
U6, U7, U9: (no value)
U17: THS7353; TSSOP-20_4.4x6.5mm_Pitch0.65mm_Handsoldering
U18: LM3671MF-2.5/NOPB; SOT-23-5_Handsoldering
Y1: (no value)

Connections:
/fpga1/CLK27: U1.80 (EXT_CLK), Y1.5 (OUT); also elsewhere on the board
/fpga1/RESET_N: R15.1, U1.71 (RESETB); also elsewhere on the board
/fpga1/SCL: R14.2, R38.2, U1.74 (SCL); also elsewhere on the board
/fpga1/SDA: R13.1, R44.1, U1.75 (SDA); also elsewhere on the board
/hdmitx1/5V: C31.1, C38.1, C107.1, C117.1, SW1.1 (A), U5.1 (VI), U6.1 (IN), U6.3 (EN), U18.1 (Vin), U18.3 (EN); also elsewhere on the board
/hdmitx1/AV1_AUD_L: D5.1 (TVS1), J3.6, SW4.1; also elsewhere on the board
/hdmitx1/AV1_AUD_R: D5.2 (TVS2), J3.2, SW4.4; also elsewhere on the board
/hdmitx1/AV2_AUD_L: SW4.3; also elsewhere on the board
/hdmitx1/AV2_AUD_R: SW4.6; also elsewhere on the board
/hdmitx1/AV3_AUD_L: D12.2 (TVS2), J7.2; also elsewhere on the board
/hdmitx1/AV3_AUD_R: D12.1 (TVS1), J7.3; also elsewhere on the board
/hdmitx1/AVDD3V3: C10.1, C18.2, C70.1, C71.1, C95.1, U1.13 (A33VDD), U1.14 (A33VDD), U1.93 (A33VDD), U1.94 (A33VDD), U6.5 (OUT), U17.11 (VCC); also elsewhere on the board
/hdmitx1/DVDD3V3: C14.1, C22.1, C26.1, C28.1, C72.1, C93.1, FB5.2, R13.2, R14.1, U1.26 (IOVDD), U1.41 (IOVDD), U1.53 (IOVDD), U1.66 (IOVDD), U4.5 (Vcc), U5.3 (VO); also elsewhere on the board
/tvp_board1/AVDD: C35.1, FB6.1, FB7.1, U7.5 (OUT)
/tvp_board1/AVDD_F: C8.1, C9.1, FB6.2, U1.4 (AVDD), U1.6 (AVDD), U1.7 (AVDD), U1.19 (AVDD)
/tvp_board1/B0: U1.36 (B_2); also elsewhere on the board
/tvp_board1/B1: U1.35 (B_3); also elsewhere on the board
/tvp_board1/B2: U1.34 (B_4); also elsewhere on the board
/tvp_board1/B3: U1.33 (B_5); also elsewhere on the board
/tvp_board1/B4: U1.32 (B_6); also elsewhere on the board
/tvp_board1/B5: U1.31 (B_7); also elsewhere on the board
/tvp_board1/B6: U1.30 (B_8); also elsewhere on the board
/tvp_board1/B7: U1.29 (B_9); also elsewhere on the board
/tvp_board1/DVDD: C21.1, C27.1, C37.1, C109.1, U1.39 (DVDD), U1.69 (DVDD), U9.5 (OUT)
/tvp_board1/DVDD2V5: C32.2, C34.1, C122.1, L1.2, U7.1 (IN), U7.3 (EN), U9.1 (IN), U9.3 (EN), U18.4 (FB)
/tvp_board1/FID: U1.22 (FIDOUT); also elsewhere on the board
/tvp_board1/G0: U1.50 (G_2); also elsewhere on the board
/tvp_board1/G1: U1.49 (G_3); also elsewhere on the board
/tvp_board1/G2: U1.48 (G_4); also elsewhere on the board
/tvp_board1/G3: U1.47 (G_5); also elsewhere on the board
/tvp_board1/G4: U1.46 (G_6); also elsewhere on the board
/tvp_board1/G5: U1.45 (G_7); also elsewhere on the board
/tvp_board1/G6: U1.44 (G_8); also elsewhere on the board
/tvp_board1/G7: U1.43 (G_9); also elsewhere on the board
/tvp_board1/HSYNC: U1.24 (HSOUT); also elsewhere on the board
/tvp_board1/PCLK: U1.28 (DATACLK); also elsewhere on the board
/tvp_board1/R0: U1.63 (R_2); also elsewhere on the board
/tvp_board1/R1: U1.62 (R_3); also elsewhere on the board
/tvp_board1/R2: U1.61 (R_4); also elsewhere on the board
/tvp_board1/R3: U1.59 (R_5); also elsewhere on the board
/tvp_board1/R4: U1.58 (R_6); also elsewhere on the board
/tvp_board1/R5: U1.57 (R_7); also elsewhere on the board
/tvp_board1/R6: U1.56 (R_8); also elsewhere on the board
/tvp_board1/R7: U1.55 (R_9); also elsewhere on the board
/tvp_board1/RGB1_B: C7.1, D8.4 (TVS3), J3.7, R8.1
/tvp_board1/RGB1_G: C5.1, D8.3 (TVS2), J3.11, R6.1
/tvp_board1/RGB1_R: C6.1, D8.5 (TVS4), J3.15, R7.1
/tvp_board1/RGB1_S: C13.1, D8.1 (TVS1), J3.20, R3.1
/tvp_board1/RGB2_B: C4.1, D10.4 (TVS3), J2.2 (Pb), R5.1
/tvp_board1/RGB2_G: C12.1, D10.3 (TVS2), J2.1 (Y), R9.1
/tvp_board1/RGB2_R: C3.1, D10.1 (TVS1), J2.3 (Pr), R4.1
/tvp_board1/RGB3_B: C2.1, D9.4 (TVS3), J1.3 (BLUE), R2.1
/tvp_board1/RGB3_G: C15.1, C16.1, D9.3 (TVS2), J1.2 (GREEN), R10.2
/tvp_board1/RGB3_HS: D13.3 (IO2), J1.13 (HSYNC), U4.1 (1A)
/tvp_board1/RGB3_HS_B: U1.81 (HSYNC_A), U4.6 (1Y)
/tvp_board1/RGB3_R: C1.1, D9.1 (TVS1), J1.1 (RED), R1.1
/tvp_board1/RGB3_VS: D13.1 (IO1), J1.14 (VSYNC), R12.2
/tvp_board1/RGB3_VS_B: U1.78 (VSYNC_A), U4.4 (2Y)
/tvp_board1/RGB_12_B: C100.1, U17.14 (CH3_GA), U17.15 (OUT_CH3)
/tvp_board1/RGB_12_G: C11.1, C103.1, U17.18 (CH1_GA), U17.19 (OUT_CH1)
/tvp_board1/RGB_12_R: C76.1, U17.16 (CH2_GA), U17.17 (OUT_CH2)
/tvp_board1/VSYNC: U1.23 (VSOUT); also elsewhere on the board
unnamed: C1.2, U1.9 (RIN_3)
unnamed: C2.2, U1.16 (BIN_3)
unnamed: C3.2, U17.3 (IN_A_CH2)
unnamed: C4.2, U17.4 (IN_A_CH3)
unnamed: C5.2, U17.5 (IN_B_CH1)
unnamed: C6.2, U17.6 (IN_B_CH2)
unnamed: C7.2, U17.7 (IN_B_CH3)
unnamed: C11.2, U1.1 (SOGIN_1)
unnamed: C12.2, U17.2 (IN_A_CH1)
unnamed: C13.2, U1.99 (SOGIN_2)
unnamed: C15.2, U1.98 (GIN_3)
unnamed: C16.2, U1.97 (SOGIN_3)
unnamed: C17.2, U1.96 (GIN_4)
unnamed: C19.1, U1.88 (FILT2)
unnamed: C19.2, C20.1, U1.89 (PLL_F)
unnamed: C20.2, R11.1
unnamed: C23.1, FB7.2, U1.84 (PLL_AVDD), U1.85 (PLL_AVDD)
unnamed: C24.1, R12.1, U4.3 (2A)
unnamed: C25.1, FB5.1, Y1.8 (VDD)
unnamed: C33.2, R38.1, U17.13 (SCL)
unnamed: C36.1, R44.2, U17.12 (SDA)
unnamed: C76.2, U1.11 (RIN_1)
unnamed: C100.2, U1.18 (BIN_1)
unnamed: C103.2, U1.2 (GIN_1)
unnamed: C104.2, U1.10 (RIN_2)
unnamed: C105.2, U1.17 (BIN_2)
unnamed: C106.1, U1.100 (GIN_2)
unnamed: D11.1 (TVS1), J6.3, SW4.5
unnamed: D11.2 (TVS2), J6.2, SW4.2
unnamed: D14.1 (K), R55.2, R56.1
unnamed: F1.1, J5.1
unnamed: F1.2, Q3.3 (D)
unnamed: L1.1, U18.5 (SW)
unnamed: Q3.1 (G), R53.1, R54.2
unnamed: Q3.2 (S), Q4.2 (E), Q5.2 (S), R54.1, R55.1, R57.1
unnamed: Q4.1 (B), R56.2
unnamed: Q4.3 (C), Q5.1 (G), R57.2, R58.1
unnamed: Q5.3 (D), SW1.2 (B)
unnamed: R11.2, U1.87 (FILT1)

Notes on the sheet:
max. 25mA
<=589mA (max. 1000mA)
max. 20mA
<=279mA (max. 300mA)
max. 279mA (AVDD)
<=111mA (max. 200mA)
max. 23mA (PLL_VDD)
max. 89mA (DVDD)
max. 110mA (A33VDD)
reverse current protection
<= 368mA (max. 600mA)
Total from 5V rail: 589mA+111mA+ ((2.5V/5V)*368mA)/0.9 <=904mA
max. 102mA (IOVDD)
max. 5mA
overvoltage protection, Vth = 5.5V
<=89mA (max. 200mA)

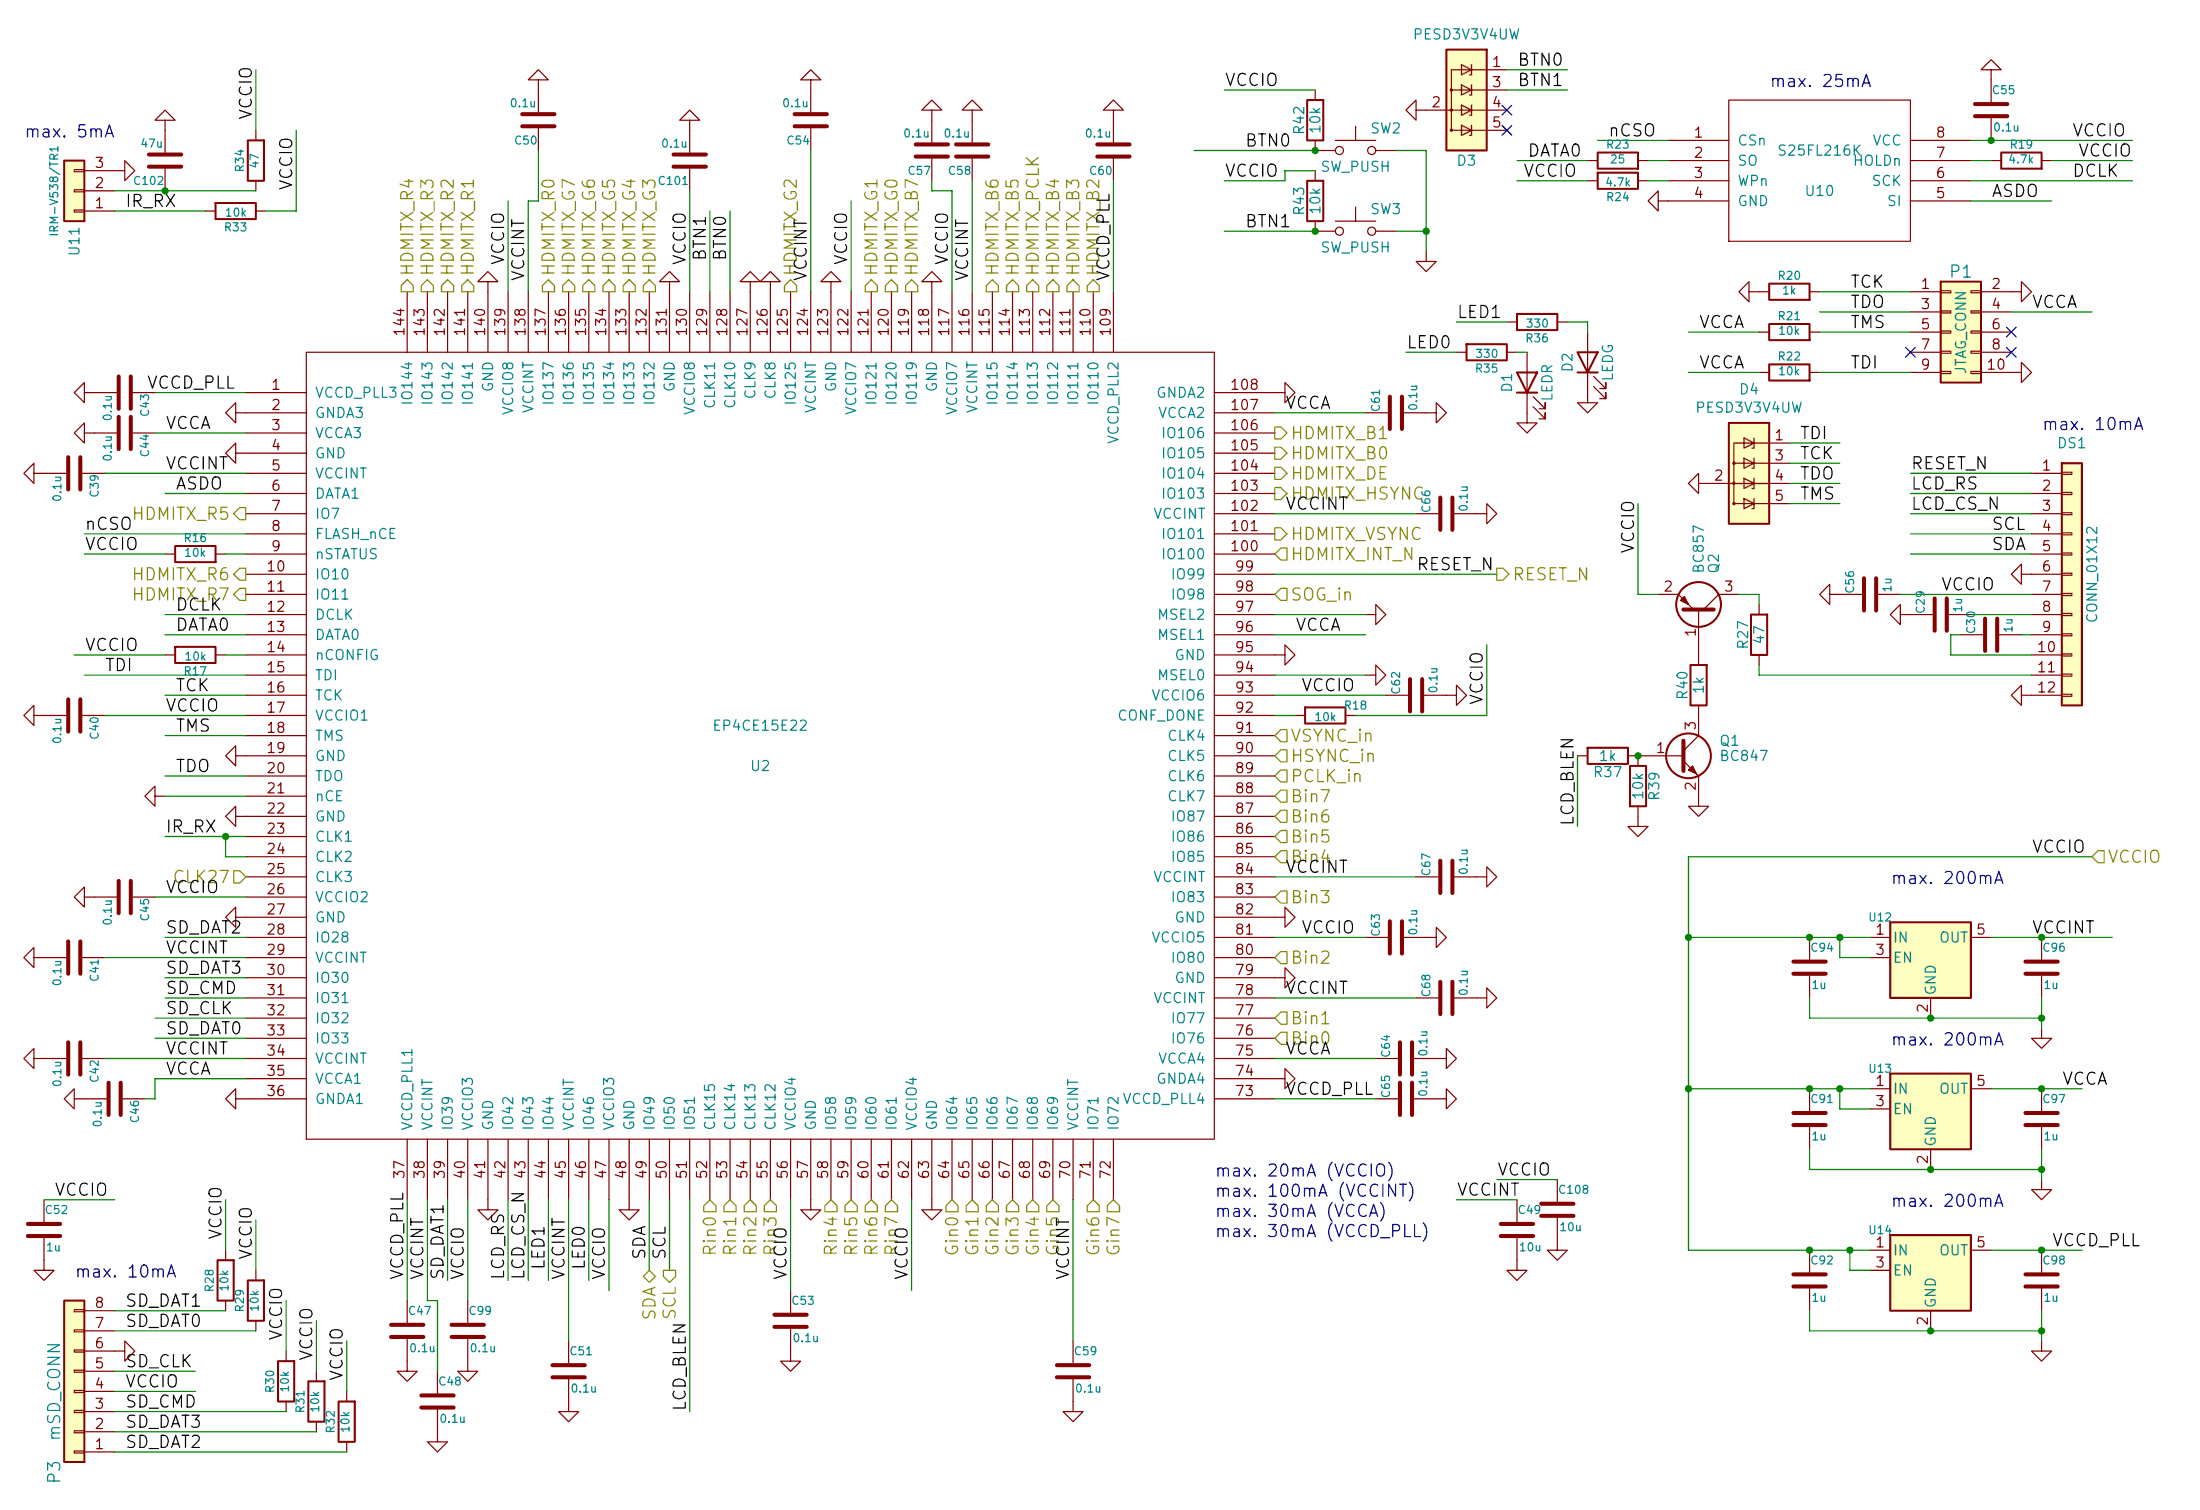
[picture p9: schematic fpga.kicad_sch, Open Source Scan Converter]

Parts:
C29, C30, C52, C56, C91, C92, C94, C96, C97, C98: 1u; SM0603_Capa_libcms
C39, C40, C41, C42, C43, C44, C45, C46, C47, C48, C50, C51, C53, C54, C55, C57, C58, C59, C60, C61, C62, C63, C64, C65, C66, C67, C68, C99, C101: 0.1u; SM0603_Capa_libcms
C49, C108: 10u; SM0603_Capa_libcms
C102: 47u; SM0805_libcms
D1: LEDR; LED-0603
D2: LEDG; LED-0603
D3, D4: PESD3V3V4UW; SOT-665
DS1: CONN_01X12; NHD-C0216CZ_vertmount
P1: JTAG_CONN; VASCH5x2
P3: mSD_CONN; DM3D-SF; Part ID DM3D-SF
Q1: BC847; SOT-23_Handsoldering
Q2: BC857; SOT-23_Handsoldering
R16, R17, R18, R21, R22, R28, R29, R30, R31, R32, R33, R39, R42, R43: 10k; SM0603_Resistor_libcms
R19, R24: 4.7k; SM0603_Resistor_libcms
R20, R37, R40: 1k; SM0603_Resistor_libcms
R23: 25; SM0603_Resistor_libcms
R27, R34: 47; SM0603_Resistor_libcms
R35, R36: 330; SM0603_Resistor_libcms
SW2, SW3: SW_PUSH; SW_PUSH-SKHCBFA010
U2: EP4CE15E22; TQFP-144_thermal
U10: S25FL216K; SOIC-8_3.9x4.9mm_Pitch1.27mm_Handsoldering
U11: IRM-V538/TR1; IRM-V5XX_TR1
U12, U13, U14: (no value)

Connections:
/fpga1/ASDO: U2.6 (DATA1), U10.5 (SI)
/fpga1/BTN0: D3.1 (IO1), R42.1, SW2.1, U2.128 (CLK10)
/fpga1/BTN1: D3.3 (IO2), R43.1, SW3.1, U2.129 (CLK11)
/fpga1/CLK27: U2.25 (CLK3); also elsewhere on the board
/fpga1/DATA0: R23.1, U2.13 (DATA0)
/fpga1/DCLK: U2.12 (DCLK), U10.6 (SCK)
/fpga1/HDMITX_HSYNC: U2.103 (IO103); also elsewhere on the board
/fpga1/HDMITX_INT_N: U2.100 (IO100); also elsewhere on the board
/fpga1/HDMITX_PCLK: U2.113 (IO113); also elsewhere on the board
/fpga1/HDMITX_R0: U2.137 (IO137); also elsewhere on the board
/fpga1/HDMITX_R1: U2.141 (IO141); also elsewhere on the board
/fpga1/HDMITX_R2: U2.142 (IO142); also elsewhere on the board
/fpga1/HDMITX_R3: U2.143 (IO143); also elsewhere on the board
/fpga1/HDMITX_R4: U2.144 (IO144); also elsewhere on the board
/fpga1/HDMITX_R5: U2.7 (IO7); also elsewhere on the board
/fpga1/HDMITX_R6: U2.10 (IO10); also elsewhere on the board
/fpga1/HDMITX_R7: U2.11 (IO11); also elsewhere on the board
/fpga1/HDMITX_VSYNC: U2.101 (IO101); also elsewhere on the board
/fpga1/LCD_BLEN: R37.2, U2.51 (IO51)
/fpga1/LCD_CS_N: DS1.3, U2.43 (IO43)
/fpga1/LCD_RS: DS1.2, U2.42 (IO42)
/fpga1/LED0: R35.2, U2.46 (IO46)
/fpga1/LED1: R36.2, U2.44 (IO44)
/fpga1/RESET_N: DS1.1, U2.99 (IO99); also elsewhere on the board
/fpga1/SCL: DS1.4, U2.50 (IO50); also elsewhere on the board
/fpga1/SDA: DS1.5, U2.49 (IO49); also elsewhere on the board
/fpga1/SD_CLK: P3.5, U2.32 (IO32)
/fpga1/SD_CMD: P3.3, R30.1, U2.31 (IO31)
/fpga1/SD_DAT0: P3.7, R29.1, U2.33 (IO33)
/fpga1/SD_DAT1: P3.8, R28.1, U2.39 (IO39)
/fpga1/SD_DAT2: P3.1, R32.1, U2.28 (IO28)
/fpga1/SD_DAT3: P3.2, R31.1, U2.30 (IO30)
/fpga1/TCK: D4.3 (IO2), P1.1, R20.2, U2.16 (TCK)
/fpga1/TDI: D4.1 (IO1), P1.9, R22.2, U2.15 (TDI)
/fpga1/TDO: D4.4 (IO3), P1.3, U2.20 (TDO)
/fpga1/TMS: D4.5 (IO4), P1.5, R21.2, U2.18 (TMS)
/fpga1/VCCA: C44.1, C46.1, C61.1, C64.1, C97.1, P1.4, R21.1, R22.1, U2.3 (VCCA3), U2.35 (VCCA1), U2.75 (VCCA4), U2.96 (MSEL1), U2.107 (VCCA2), U13.5 (OUT)
/fpga1/VCCD_PLL: C43.1, C47.1, C60.1, C65.1, C98.1, U2.1 (VCCD_PLL3), U2.37 (VCCD_PLL1), U2.73 (VCCD_PLL4), U2.109 (VCCD_PLL2), U14.5 (OUT)
/fpga1/VCCINT: C39.1, C41.1, C42.1, C48.1, C49.1, C50.1, C51.1, C54.1, C58.1, C59.1, C66.1, C67.1, C68.1, C96.1, U2.5 (VCCINT), U2.29 (VCCINT), U2.34 (VCCINT), U2.38 (VCCINT), U2.45 (VCCINT), U2.70 (VCCINT), U2.78 (VCCINT), U2.84 (VCCINT), U2.102 (VCCINT), U2.116 (VCCINT), U2.124 (VCCINT), U2.138 (VCCINT), U12.5 (OUT)
/fpga1/nCSO: U2.8 (FLASH_nCE), U10.1 (CSn)
/hdmitx1/B0: U2.105 (IO105); also elsewhere on the board
/hdmitx1/B1: U2.106 (IO106); also elsewhere on the board
/hdmitx1/B2: U2.110 (IO110); also elsewhere on the board
/hdmitx1/B3: U2.111 (IO111); also elsewhere on the board
/hdmitx1/B4: U2.112 (IO112); also elsewhere on the board
/hdmitx1/B5: U2.114 (IO114); also elsewhere on the board
/hdmitx1/B6: U2.115 (IO115); also elsewhere on the board
/hdmitx1/B7: U2.119 (IO119); also elsewhere on the board
/hdmitx1/DE: U2.104 (IO104); also elsewhere on the board
/hdmitx1/DVDD3V3: C40.1, C45.1, C52.1, C53.1, C55.2, C56.2, C57.1, C62.1, C63.1, C91.1, C92.1, C94.1, C99.1, C101.1, C108.1, DS1.7, P3.4, Q2.2 (E), R16.1, R17.2, R18.1, R19.2, R24.2, R28.2, R29.2, R30.2, R31.2, R32.2, R33.1, R34.2, R42.2, R43.2, U2.17 (VCCIO1), U2.26 (VCCIO2), U2.40 (VCCIO3), U2.47 (VCCIO3), U2.56 (VCCIO4), U2.62 (VCCIO4), U2.81 (VCCIO5), U2.93 (VCCIO6), U2.117 (VCCIO7), U2.122 (VCCIO7), U2.130 (VCCIO8), U2.139 (VCCIO8), U10.8 (VCC), U12.1 (IN), U12.3 (EN), U13.1 (IN), U13.3 (EN), U14.1 (IN), U14.3 (EN); also elsewhere on the board
/hdmitx1/G0: U2.120 (IO120); also elsewhere on the board
/hdmitx1/G1: U2.121 (IO121); also elsewhere on the board
/hdmitx1/G2: U2.125 (IO125); also elsewhere on the board
/hdmitx1/G3: U2.132 (IO132); also elsewhere on the board
/hdmitx1/G4: U2.133 (IO133); also elsewhere on the board
/hdmitx1/G5: U2.134 (IO134); also elsewhere on the board
/hdmitx1/G6: U2.135 (IO135); also elsewhere on the board
/hdmitx1/G7: U2.136 (IO136); also elsewhere on the board
/tvp_board1/B0: U2.76 (IO76); also elsewhere on the board
/tvp_board1/B1: U2.77 (IO77); also elsewhere on the board
/tvp_board1/B2: U2.80 (IO80); also elsewhere on the board
/tvp_board1/B3: U2.83 (IO83); also elsewhere on the board
/tvp_board1/B4: U2.85 (IO85); also elsewhere on the board
/tvp_board1/B5: U2.86 (IO86); also elsewhere on the board
/tvp_board1/B6: U2.87 (IO87); also elsewhere on the board
/tvp_board1/B7: U2.88 (CLK7); also elsewhere on the board
/tvp_board1/FID: U2.98 (IO98); also elsewhere on the board
/tvp_board1/G0: U2.64 (IO64); also elsewhere on the board
/tvp_board1/G1: U2.65 (IO65); also elsewhere on the board
/tvp_board1/G2: U2.66 (IO66); also elsewhere on the board
/tvp_board1/G3: U2.67 (IO67); also elsewhere on the board
/tvp_board1/G4: U2.68 (IO68); also elsewhere on the board
/tvp_board1/G5: U2.69 (IO69); also elsewhere on the board
/tvp_board1/G6: U2.71 (IO71); also elsewhere on the board
/tvp_board1/G7: U2.72 (IO72); also elsewhere on the board
/tvp_board1/HSYNC: U2.90 (CLK5); also elsewhere on the board
/tvp_board1/PCLK: U2.89 (CLK6); also elsewhere on the board
/tvp_board1/R0: U2.52 (CLK15); also elsewhere on the board
/tvp_board1/R1: U2.53 (CLK14); also elsewhere on the board
/tvp_board1/R2: U2.54 (CLK13); also elsewhere on the board
/tvp_board1/R3: U2.55 (CLK12); also elsewhere on the board
/tvp_board1/R4: U2.58 (IO58); also elsewhere on the board
/tvp_board1/R5: U2.59 (IO59); also elsewhere on the board
/tvp_board1/R6: U2.60 (IO60); also elsewhere on the board
/tvp_board1/R7: U2.61 (IO61); also elsewhere on the board
/tvp_board1/VSYNC: U2.91 (CLK4); also elsewhere on the board
unnamed: C29.2, DS1.8
unnamed: C30.1, DS1.10
unnamed: C30.2, DS1.9
unnamed: C102.1, R34.1, U11.2
unnamed: D1.2 (A), R35.1
unnamed: D2.2 (A), R36.1
unnamed: DS1.11, R27.1
unnamed: Q1.1 (B), R37.1, R39.1
unnamed: Q1.3 (C), R40.1
unnamed: Q2.1 (B), R40.2
unnamed: Q2.3 (C), R27.2
unnamed: R16.2, U2.9 (nSTATUS)
unnamed: R17.1, U2.14 (nCONFIG)
unnamed: R18.2, U2.92 (CONF_DONE)
unnamed: R19.1, U10.7 (HOLDn)
unnamed: R23.2, U10.2 (SO)
unnamed: R24.1, U10.3 (WPn)

Notes on the sheet:
max. 200mA
max. 10mA
max. 100mA (VCCINT)
max. 25mA
max. 20mA (VCCIO)
max. 5mA
max. 30mA (VCCD_PLL)
max. 30mA (VCCA)

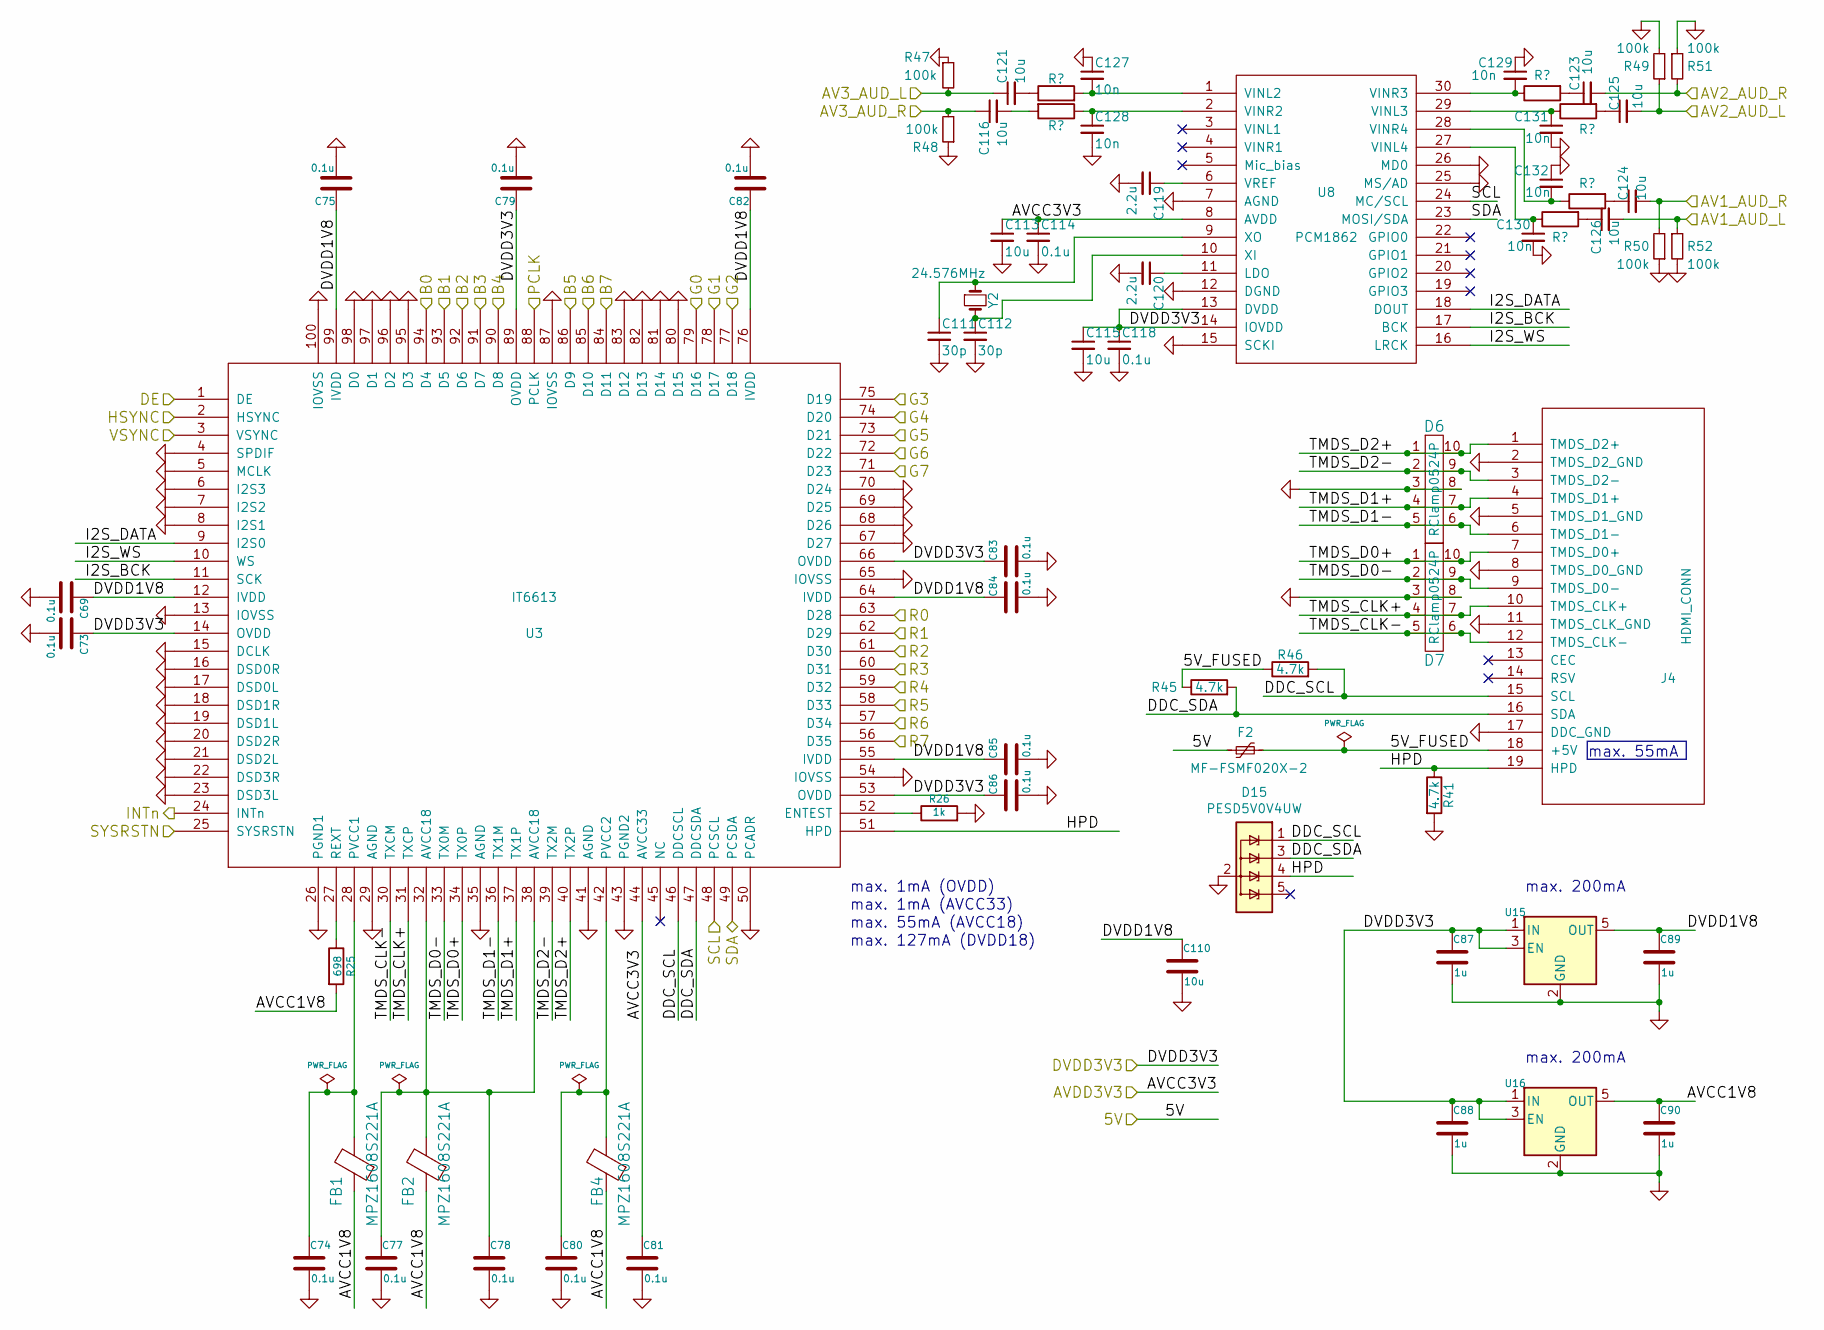
[picture p10: schematic hdmitx.kicad_sch, Open Source Scan Converter]

Parts:
C69, C73, C74, C75, C77, C78, C79, C80, C81, C82, C83, C84, C85, C86, C114, C118: 0.1u; SM0603_Capa_libcms
C87, C88, C89, C90: 1u; SM0603_Capa_libcms
C110, C113, C115, C116, C121, C123, C124, C125, C126: 10u; SM0603_Capa_libcms
C111, C112: 30p; SM0603_Capa_libcms
C119, C120: 2.2u; SM0603_Capa_libcms
C127, C128, C129, C130, C131, C132: 10n; SM0603_Capa_libcms
D6, D7: RClamp0524P; SLP2510P8
D15: PESD5V0V4UW; SOT-665
F2: MF-FSMF020X-2; SM0603_Resistor_libcms
FB1, FB2, FB4: MPZ1608S221A; SM0603_Resistor_libcms
J4: HDMI_CONN; HDMI_CONN-10029449-111RLF; Part ID 10029449-111RLF
R25: 698; SM0603_Resistor_libcms
R26: 1k; SM0603_Resistor_libcms
R41, R45, R46: 4.7k; SM0603_Resistor_libcms
R47, R48, R49, R50, R51, R52: 100k; SM0603_Resistor_libcms
U3: IT6613; TQFP-100_custom
U8: PCM1862; TSSOP-30_4.4x7.8mm_Pitch0.5mm_Handsoldering
U15, U16: (no value)
Y2: 24.576MHz; ECS-3X9X

Connections:
/fpga1/HDMITX_HSYNC: U3.2 (HSYNC); also elsewhere on the board
/fpga1/HDMITX_INT_N: U3.24 (INTn); also elsewhere on the board
/fpga1/HDMITX_PCLK: U3.88 (PCLK); also elsewhere on the board
/fpga1/HDMITX_R0: U3.63 (D28); also elsewhere on the board
/fpga1/HDMITX_R1: U3.62 (D29); also elsewhere on the board
/fpga1/HDMITX_R2: U3.61 (D30); also elsewhere on the board
/fpga1/HDMITX_R3: U3.60 (D31); also elsewhere on the board
/fpga1/HDMITX_R4: U3.59 (D32); also elsewhere on the board
/fpga1/HDMITX_R5: U3.58 (D33); also elsewhere on the board
/fpga1/HDMITX_R6: U3.57 (D34); also elsewhere on the board
/fpga1/HDMITX_R7: U3.56 (D35); also elsewhere on the board
/fpga1/HDMITX_VSYNC: U3.3 (VSYNC); also elsewhere on the board
/fpga1/RESET_N: U3.25 (SYSRSTN); also elsewhere on the board
/fpga1/SCL: U3.48 (PCSCL), U8.24 (MC/SCL); also elsewhere on the board
/fpga1/SDA: U3.49 (PCSDA), U8.23 (MOSI/SDA); also elsewhere on the board
/hdmitx1/5V: F2.1; also elsewhere on the board
/hdmitx1/5V_FUSED: F2.2, J4.18 (+5V), R45.1, R46.1
/hdmitx1/AV1_AUD_L: C126.2, R52.1; also elsewhere on the board
/hdmitx1/AV1_AUD_R: C124.2, R50.2; also elsewhere on the board
/hdmitx1/AV2_AUD_L: C125.2, R49.1; also elsewhere on the board
/hdmitx1/AV2_AUD_R: C123.2, R51.2; also elsewhere on the board
/hdmitx1/AV3_AUD_L: C121.1, R47.2; also elsewhere on the board
/hdmitx1/AV3_AUD_R: C116.1, R48.2; also elsewhere on the board
/hdmitx1/AVCC1V8: C90.1, FB1.1, FB2.1, FB4.1, R25.2, U16.5 (OUT)
/hdmitx1/AVDD3V3: C81.1, C113.1, C114.1, U3.44 (AVCC33), U8.8 (AVDD); also elsewhere on the board
/hdmitx1/B0: U3.94 (D4); also elsewhere on the board
/hdmitx1/B1: U3.93 (D5); also elsewhere on the board
/hdmitx1/B2: U3.92 (D6); also elsewhere on the board
/hdmitx1/B3: U3.91 (D7); also elsewhere on the board
/hdmitx1/B4: U3.90 (D8); also elsewhere on the board
/hdmitx1/B5: U3.86 (D9); also elsewhere on the board
/hdmitx1/B6: U3.85 (D10); also elsewhere on the board
/hdmitx1/B7: U3.84 (D11); also elsewhere on the board
/hdmitx1/DDC_SCL: D15.1 (IO1), J4.15 (SCL), R46.2, U3.46 (DDCSCL)
/hdmitx1/DDC_SDA: D15.3 (IO2), J4.16 (SDA), R45.2, U3.47 (DDCSDA)
/hdmitx1/DE: U3.1 (DE); also elsewhere on the board
/hdmitx1/DVDD1V8: C69.1, C75.1, C82.1, C84.1, C85.1, C89.1, C110.1, U3.12 (IVDD), U3.55 (IVDD), U3.64 (IVDD), U3.76 (IVDD), U3.99 (IVDD), U15.5 (OUT)
/hdmitx1/DVDD3V3: C73.1, C79.1, C83.1, C86.1, C87.1, C88.1, C115.1, C118.1, U3.14 (OVDD), U3.53 (OVDD), U3.66 (OVDD), U3.89 (OVDD), U8.13 (DVDD), U8.14 (IOVDD), U15.1 (IN), U15.3 (EN), U16.1 (IN), U16.3 (EN); also elsewhere on the board
/hdmitx1/G0: U3.79 (D16); also elsewhere on the board
/hdmitx1/G1: U3.78 (D17); also elsewhere on the board
/hdmitx1/G2: U3.77 (D18); also elsewhere on the board
/hdmitx1/G3: U3.75 (D19); also elsewhere on the board
/hdmitx1/G4: U3.74 (D20); also elsewhere on the board
/hdmitx1/G5: U3.73 (D21); also elsewhere on the board
/hdmitx1/G6: U3.72 (D22); also elsewhere on the board
/hdmitx1/G7: U3.71 (D23); also elsewhere on the board
/hdmitx1/HPD: D15.4 (IO3), J4.19 (HPD), R41.1, U3.51 (HPD)
/hdmitx1/I2S_BCK: U3.11 (SCK), U8.17 (BCK)
/hdmitx1/I2S_DATA: U3.9 (I2S0), U8.18 (DOUT)
/hdmitx1/I2S_WS: U3.10 (WS), U8.16 (LRCK)
/hdmitx1/TMDS_CLK+: D7.4, D7.7, J4.10 (TMDS_CLK+), U3.31 (TXCP)
/hdmitx1/TMDS_CLK-: D7.5, D7.6, J4.12 (TMDS_CLK-), U3.30 (TXCM)
/hdmitx1/TMDS_D0+: D7.1, D7.10, J4.7 (TMDS_D0+), U3.34 (TX0P)
/hdmitx1/TMDS_D0-: D7.2, D7.9, J4.9 (TMDS_D0-), U3.33 (TX0M)
/hdmitx1/TMDS_D1+: D6.4, D6.7, J4.4 (TMDS_D1+), U3.37 (TX1P)
/hdmitx1/TMDS_D1-: D6.5, D6.6, J4.6 (TMDS_D1-), U3.36 (TX1M)
/hdmitx1/TMDS_D2+: D6.1, D6.10, J4.1 (TMDS_D2+), U3.40 (TX2P)
/hdmitx1/TMDS_D2-: D6.2, D6.9, J4.3 (TMDS_D2-), U3.39 (TX2M)
unnamed: C74.1, FB1.2, U3.28 (PVCC1)
unnamed: C77.1, C78.1, FB2.2, U3.32 (AVCC18), U3.38 (AVCC18)
unnamed: C80.1, FB4.2, U3.42 (PVCC2)
unnamed: C111.1, U8.9 (XO), Y2.1
unnamed: C112.1, U8.10 (XI), Y2.2
unnamed 168: C116.2; also elsewhere on the board
unnamed: C119.1, U8.6 (VREF)
unnamed: C120.1, U8.11 (LDO)
unnamed 171: C121.2; also elsewhere on the board
unnamed 172: C123.1; also elsewhere on the board
unnamed 173: C124.1; also elsewhere on the board
unnamed 174: C125.1; also elsewhere on the board
unnamed 175: C126.1; also elsewhere on the board
unnamed 176: C127.2, U8.1 (VINL2); also elsewhere on the board
unnamed 177: C128.1, U8.2 (VINR2); also elsewhere on the board
unnamed 178: C129.2, U8.30 (VINR3); also elsewhere on the board
unnamed 179: C130.1, U8.27 (VINL4); also elsewhere on the board
unnamed 180: C131.1, U8.29 (VINL3); also elsewhere on the board
unnamed 181: C132.2, U8.28 (VINR4); also elsewhere on the board
unnamed: R25.1, U3.27 (REXT)
unnamed: R26.1, U3.52 (ENTEST)

Notes on the sheet:
max. 200mA
max. 1mA (AVCC33)
max. 127mA (DVDD18)
max. 1mA (OVDD)
max. 55mA
max. 55mA (AVCC18)

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
