marqs85/ossc_pcb/ossc_board.kicad_pcb

## KiCad design ossc_board.kicad_pcb (continued)

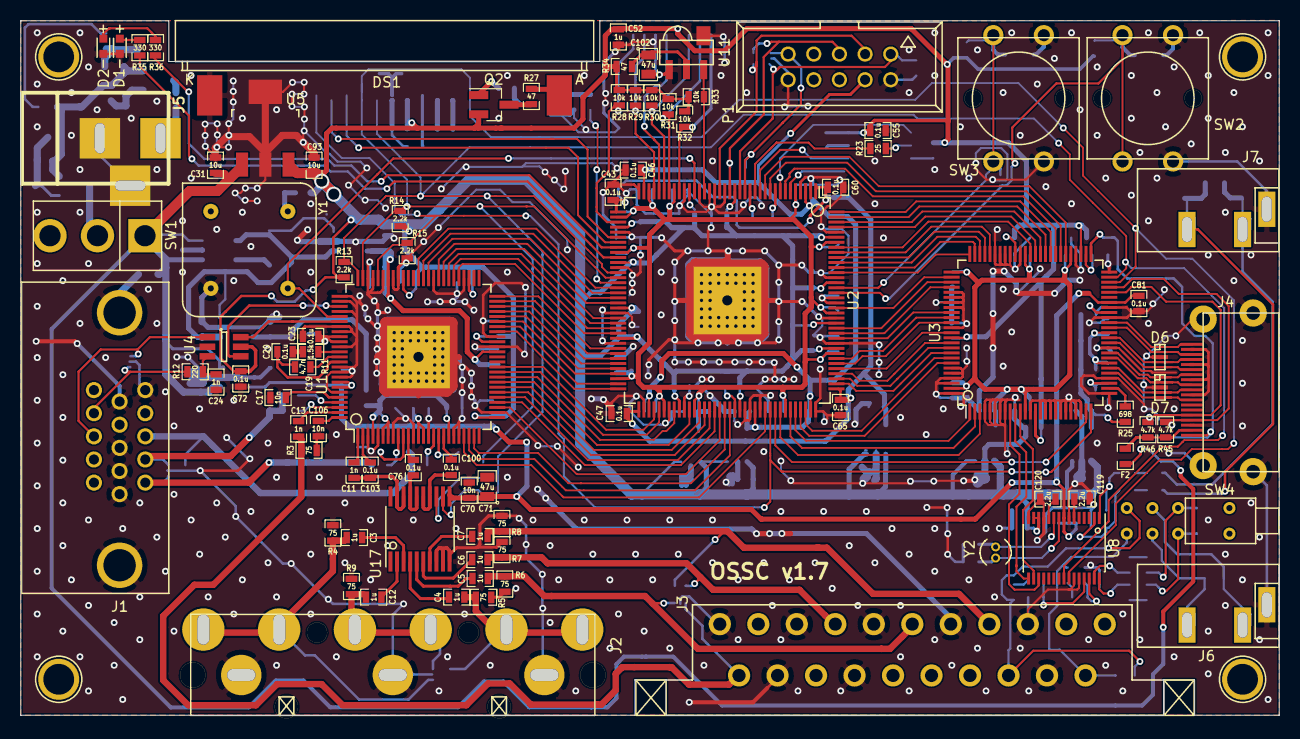
[picture p11: board ossc_board.kicad_pcb from above]

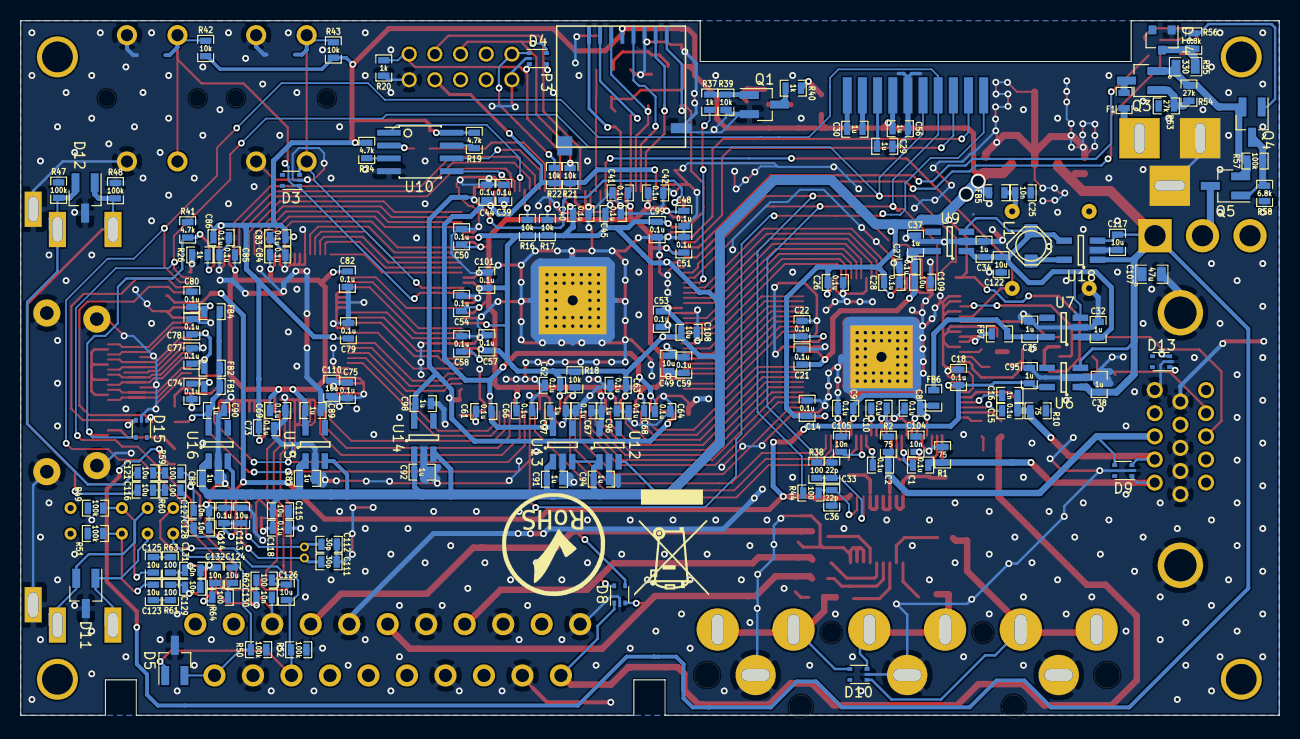
[picture p12: board ossc_board.kicad_pcb from below]

Board: 2 copper layers, 124.6 x 68.7 mm, 263 parts (171 on the bottom side), 211 nets.

Other parts of the board:
R59, R60, R61, R62, R63, R64: 100; SM0603_Resistor_libcms

Their connections:
unnamed 168: R60.2; also elsewhere on the board
unnamed 171: R59.1; also elsewhere on the board
unnamed 172: R61.2; also elsewhere on the board
unnamed 173: R64.2; also elsewhere on the board
unnamed 174: R63.2; also elsewhere on the board
unnamed 175: R62.2; also elsewhere on the board
unnamed 176: R59.2; also elsewhere on the board
unnamed 177: R60.1; also elsewhere on the board
unnamed 178: R61.1; also elsewhere on the board
unnamed 179: R62.1; also elsewhere on the board
unnamed 180: R63.1; also elsewhere on the board
unnamed 181: R64.1; also elsewhere on the board
