marqs85/ossc_pcb/(commit log)

2017-04-02 add pcb v1.6 (yet unfinished) design files
    [fpga.sch, hdmitx.sch, ossc_board.kicad_pcb, ossc_board.sch, tvp_board.sch]
2017-04-14 finalize pcb v1.6
    [bom_full.xls, fpga.sch, hdmitx.sch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]
2017-06-25 Change R12 type.
    [bom_full.xls]
2017-06-25 Add missing SMD position information.
    [ossc_board.kicad_pcb]
2017-06-30 Add case files.
2017-07-01 Update BOM links.
    [bom_full.xls]
2017-07-01 OSH Park drill fixes
    When submitting the board to OSH Park (a popular hobbyist-friendly PCB
    fabrication service), two issues are present with the OSSC PCB:
    1. It contains plated slots (for the power and audio jacks, and the
    component video connector). These *are* supported by OSH Park, but
    lines must be added to the Edge.Cuts layer so that they are milled
    out properly. Otherwise, a hole will just be drilled at the start of
    the slot, and the rest of the slot will not be cut out.
    OSH Park's upload system detects and warns users of this issue.
    See: http://docs.oshpark.com/submitting-orders/cutouts-and-slots/
    https://hackaday.io/page/1224-plated-slots-for-osh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
    [ossc_board.kicad_pcb]
2017-07-03 Regenerate PCB files after recent small updates.
    - update R12 value on schematic, netlist and layout.
    - update ECS-3X9X footprint.
    - add pdf of the schematic.
    [fpga.sch, hdmitx.sch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]
2018-01-20 update BOM and instructions
    [bom_full.xls]
2019-01-02 - Update schematics and board to KiCAD 5.x
    [fpga.sch, hdmitx.sch, ossc_board.kicad_pcb, ossc_board.sch, tvp_board.sch]
2019-01-02 Add OpenboardView version for assembly support
    [ossc_1_6_boardview.brd]
2019-01-02 Update schematics PDF after upgrade
2019-01-02 Add 4mm print extrusions from SVG for 3D Printing
    [4mm-plate-bottom.stl, 4mm-plate-middle.stl, 4mm-plate-top.stl]
2019-01-07 fix pdf rotation and update BOM
    [bom_full.xls]
2020-12-29 update to Kicad 5.x symbols
    [fpga.sch, hdmitx.sch, ossc_board.kicad_pcb, ossc_board.sch, tvp_board.sch]
2021-01-11 update to pcb v1.7
    [bom_full.xls, fpga.sch, hdmitx.sch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]
2021-07-22 fix D14 footprint and add RoHS & WEEE logos
    [bom_full.xls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]
2021-12-11 update case files and assembly instructions
    [4mm-plate-bottom.stl, 4mm-plate-middle.stl, 4mm-plate-top.stl, ossc_1_6_boardview.brd, ossc_case_bottom.step, ossc_case_top.step]
2023-05-21 initial updates for pcb v1.8
    * update to new Kicad version
    * update schematic with SOGOUT connection
    * clean up layout
    [bom_full.xls, fpga.kicad_sch, fpga.sch, hdmitx.kicad_sch, hdmitx.sch, ossc_board.kicad_sch, ossc_board.sch, tvp_board.kicad_sch]
2023-07-26 additional updates for PCB v1.8
    * change to 4-layer stackup for better power delivery
    * choose another FPGA pin for PCB version indicator
    [fpga.kicad_sch, hdmitx.kicad_sch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]
2023-07-26 update to Kicad 7 and restore RoHS and WEEE logos
    [fpga.kicad_sch, hdmitx.kicad_sch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]
2023-08-01 change PCB version indicator pin due to conflict
    [fpga.kicad_sch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]
2024-01-12 regenerate schematic pdf
